tmn24/HAVOC/HVT1.0(DO_NOT_USE)/KICAD8/Stackup.png

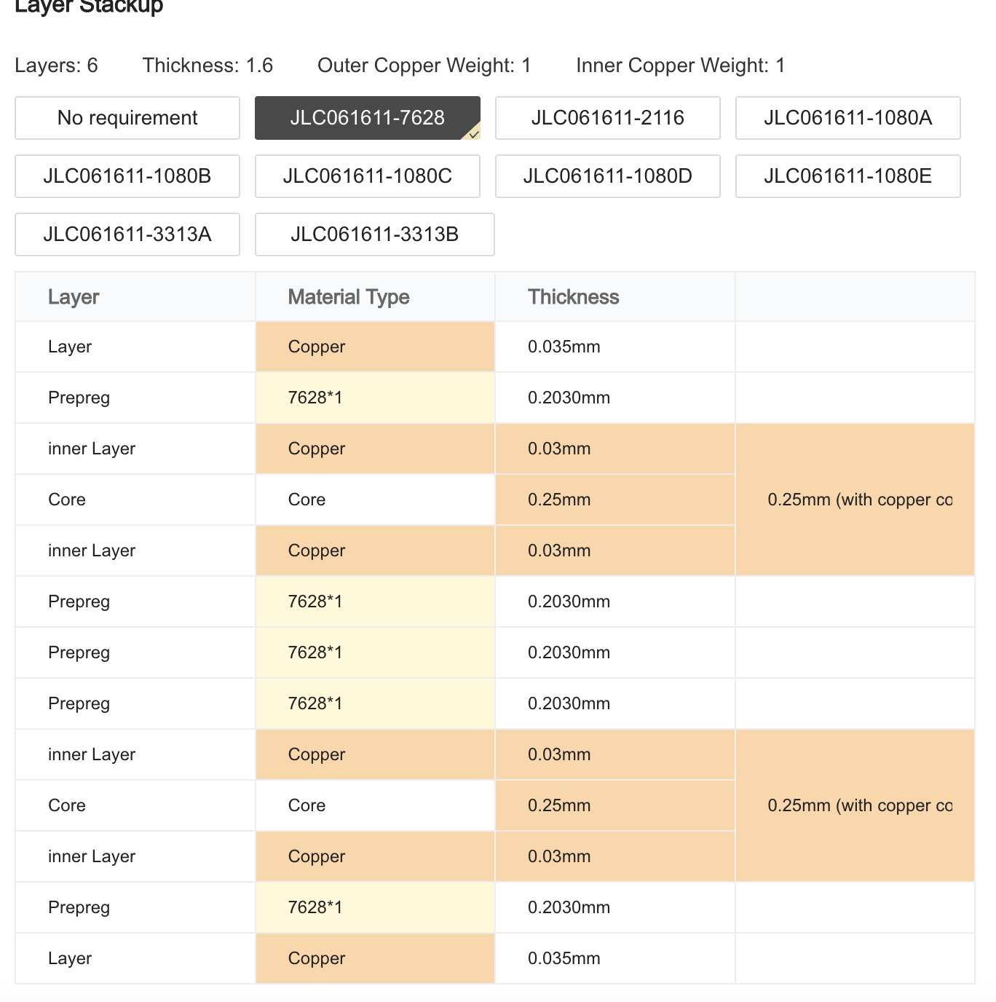
HVT1.0(DO_NOT_USE)/KICAD8/Stackup.png
