tmn24/HAVOC/HVT1.0(DO_NOT_USE)/SYMBOLS&FOOTPRINTS/BMI088/BMI088.step

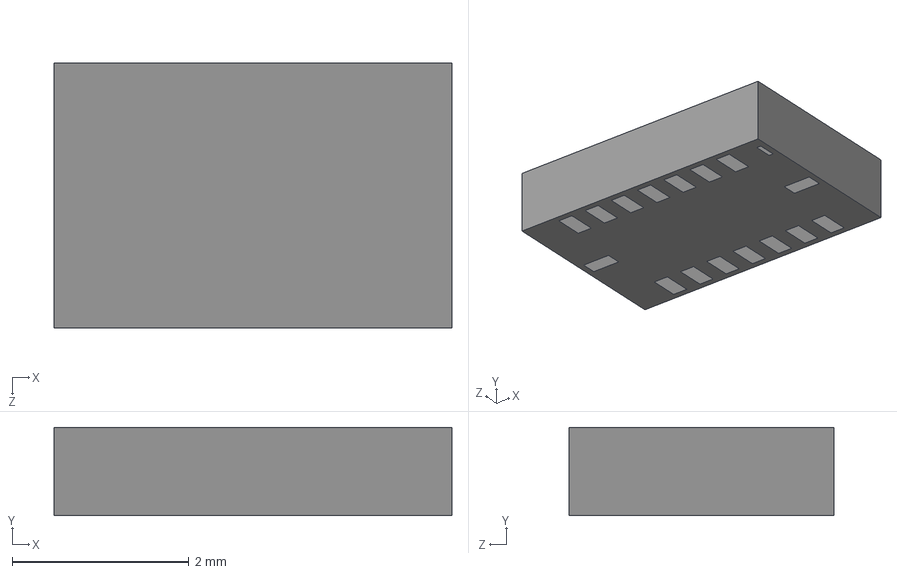
[picture p2: CAD file, 2024-08-04]
HVT1.0(DO_NOT_USE)/SYMBOLS&FOOTPRINTS/BMI088/BMI088.step
4.50 x 1.00 x 3.00 mm
