tmn24/HAVOC/HVT1.0(DO_NOT_USE)/SYMBOLS&FOOTPRINTS/LIB_VOL617A-3X001T/VOL617A-3X001T/KiCad/VOL617A-3X001T.STEP

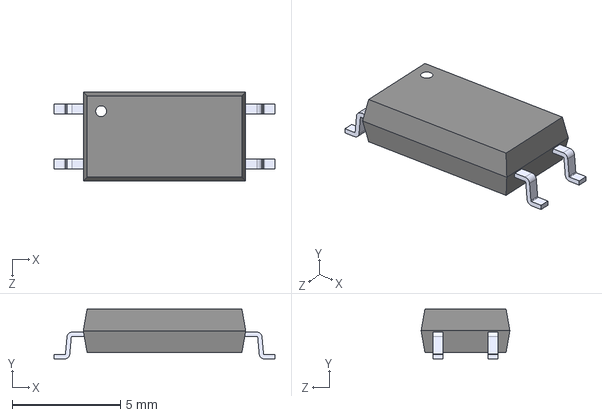
[picture p3: CAD file, 2024-08-04]
HVT1.0(DO_NOT_USE)/SYMBOLS&FOOTPRINTS/LIB_VOL617A-3X001T/VOL617A-3X001T/KiCad/VOL617A-3X001T.STEP
10.2 x 2.30 x 4.10 mm
