tmn24/HAVOC/HVT1.0(DO_NOT_USE)/SYMBOLS&FOOTPRINTS/NR6028T4R7M/NR6028T4R7M.step

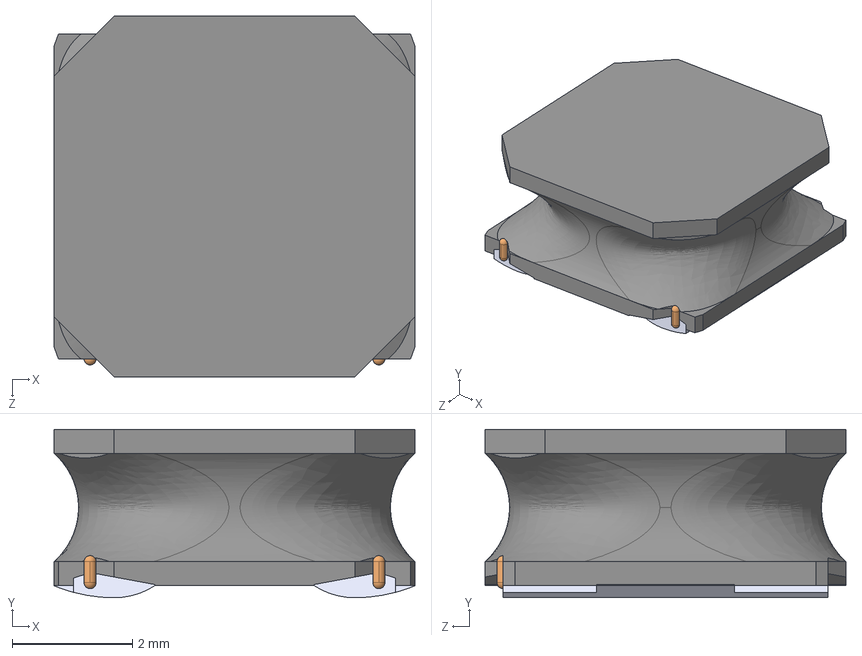
[picture p4: CAD file, 2024-08-04]
HVT1.0(DO_NOT_USE)/SYMBOLS&FOOTPRINTS/NR6028T4R7M/NR6028T4R7M.step
6.00 x 2.80 x 6.00 mm
