tmn24/HAVOC/HVT1.0(DO_NOT_USE)/SYMBOLS&FOOTPRINTS/SSB43L_E3_52T/SSB43L-E3_52T.STEP

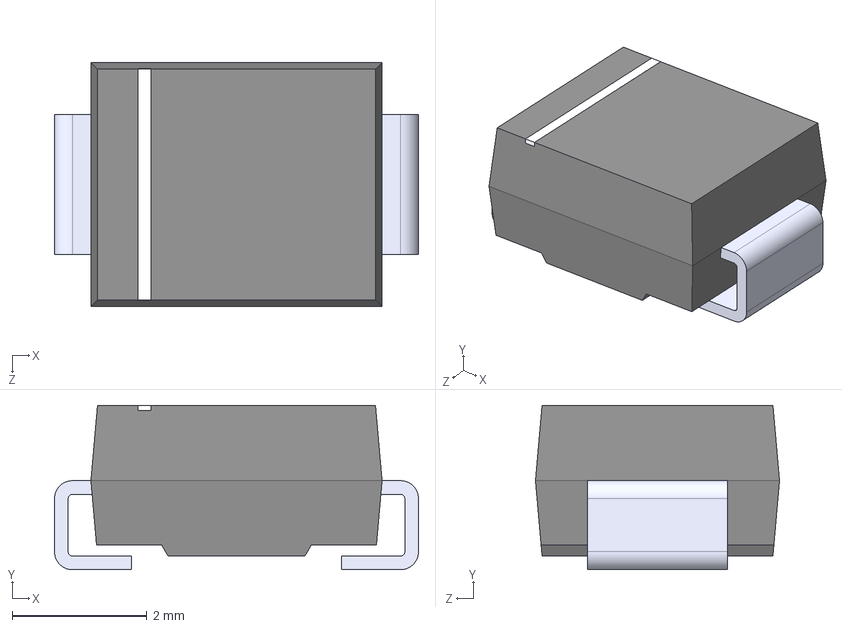
[picture p5: CAD file, 2024-08-04]
HVT1.0(DO_NOT_USE)/SYMBOLS&FOOTPRINTS/SSB43L_E3_52T/SSB43L-E3_52T.STEP
5.40 x 2.44 x 3.62 mm
