tmn24/HAVOC/HVT1.0(DO_NOT_USE)/SYMBOLS&FOOTPRINTS/STM32H755IIT6/LQFP-176.step

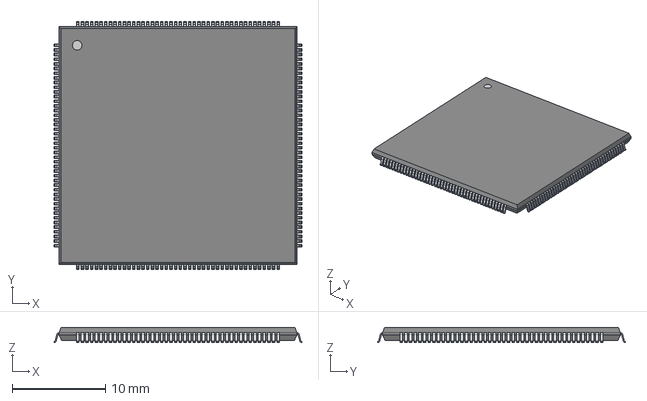
[picture p6: CAD file, 2024-08-04]
HVT1.0(DO_NOT_USE)/SYMBOLS&FOOTPRINTS/STM32H755IIT6/LQFP-176.step
26.6 x 26.6 x 1.65 mm
