tmn24/HAVOC/HVT1.0(DO_NOT_USE)/SYMBOLS&FOOTPRINTS/to-252-n-mosfet/to252-NMOSFET.step

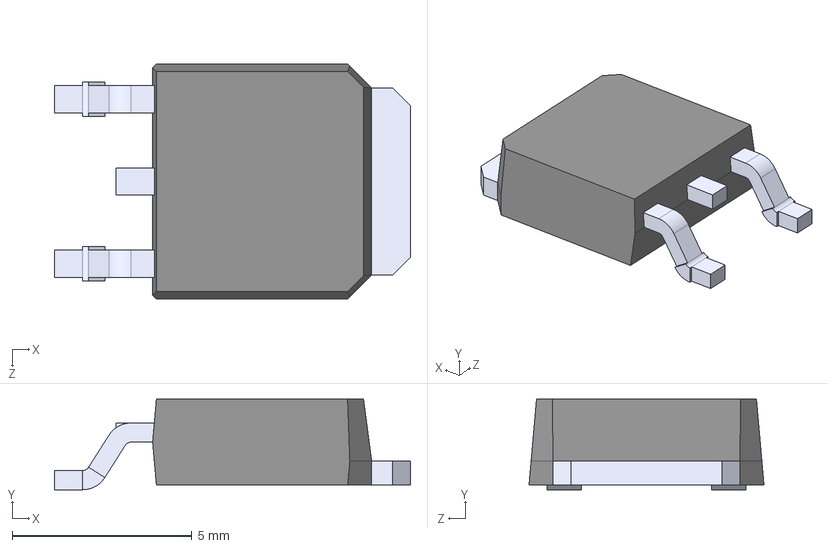
[picture p7: CAD file, 2024-08-04]
HVT1.0(DO_NOT_USE)/SYMBOLS&FOOTPRINTS/to-252-n-mosfet/to252-NMOSFET.step
9.91 x 2.52 x 6.54 mm
