tmn24/HAVOC/HVT1.0(DO_NOT_USE)/SYMBOLS&FOOTPRINTS/W25N01GVZEIG_TR/W25N01GVZEIG_TR.step

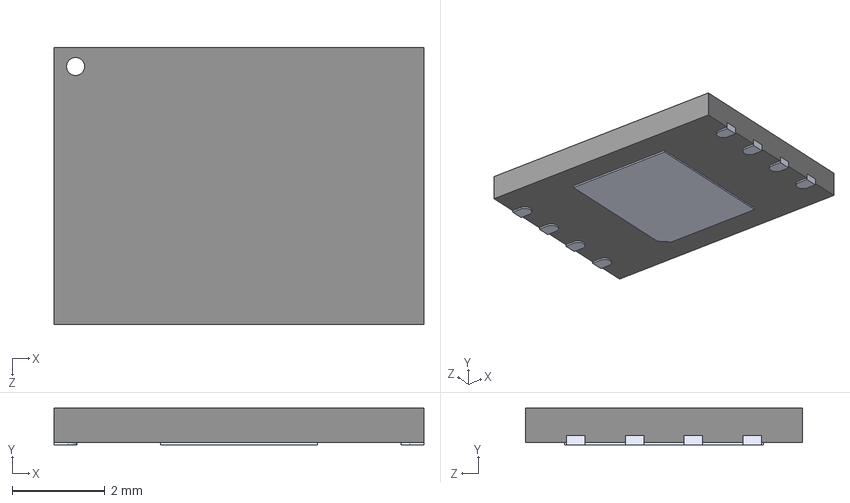
[picture p8: CAD file, 2024-08-04]
HVT1.0(DO_NOT_USE)/SYMBOLS&FOOTPRINTS/W25N01GVZEIG_TR/W25N01GVZEIG_TR.step
8.00 x 0.8 x 6.00 mm
