tmn24/HAVOC/HVT1.0(DO_NOT_USE)/SYMBOLS&FOOTPRINTS/SOIC8.STEP

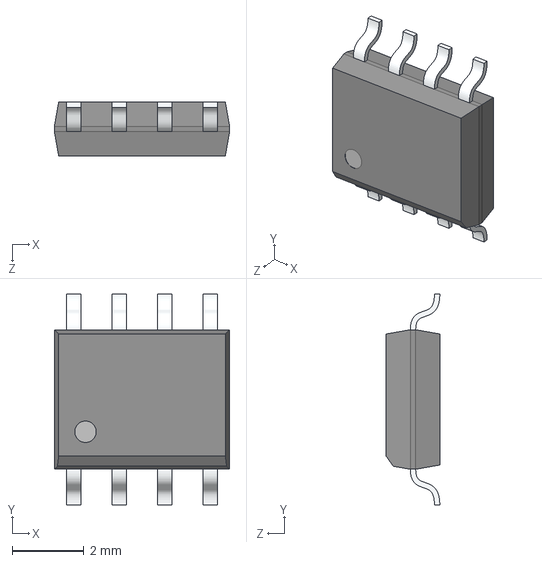
[picture p9: CAD file, 2024-08-04]
HVT1.0(DO_NOT_USE)/SYMBOLS&FOOTPRINTS/SOIC8.STEP
4.90 x 5.90 x 1.50 mm
