tmn24/HAVOC/HVT1.0(DO_NOT_USE)/SYMBOLS&FOOTPRINTS/c-1734035-2-f-3d.stp

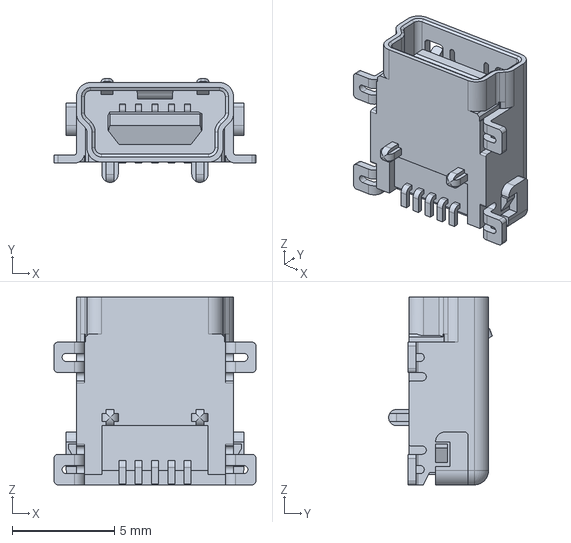
[picture p10: CAD file, 2024-08-04]
HVT1.0(DO_NOT_USE)/SYMBOLS&FOOTPRINTS/c-1734035-2-f-3d.stp
9.90 x 5.09 x 9.20 mm
