tmn24/HAVOC/HVT1.0(DO_NOT_USE)/SYMBOLS&FOOTPRINTS/ASPI4030S3R3M--3DModel-STEP-400430.STEP

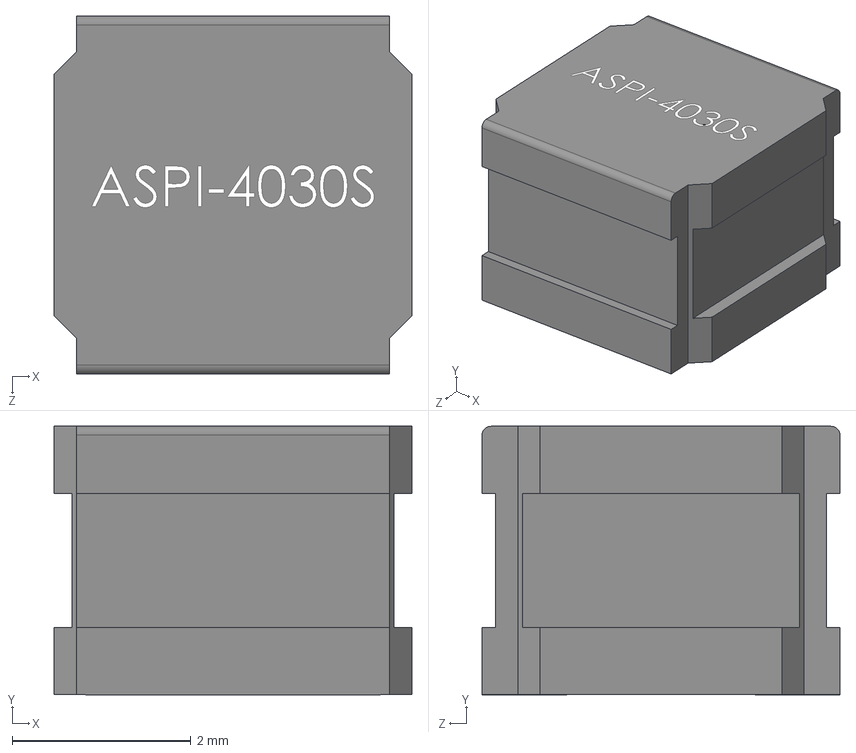
[picture p11: CAD file, 2024-08-04]
HVT1.0(DO_NOT_USE)/SYMBOLS&FOOTPRINTS/ASPI4030S3R3M--3DModel-STEP-400430.STEP
4.00 x 3.00 x 4.00 mm
