tmn24/HAVOC/HVT1.0(DO_NOT_USE)/SYMBOLS&FOOTPRINTS/MAX-M10S-00B--3DModel-STEP-269445.STEP

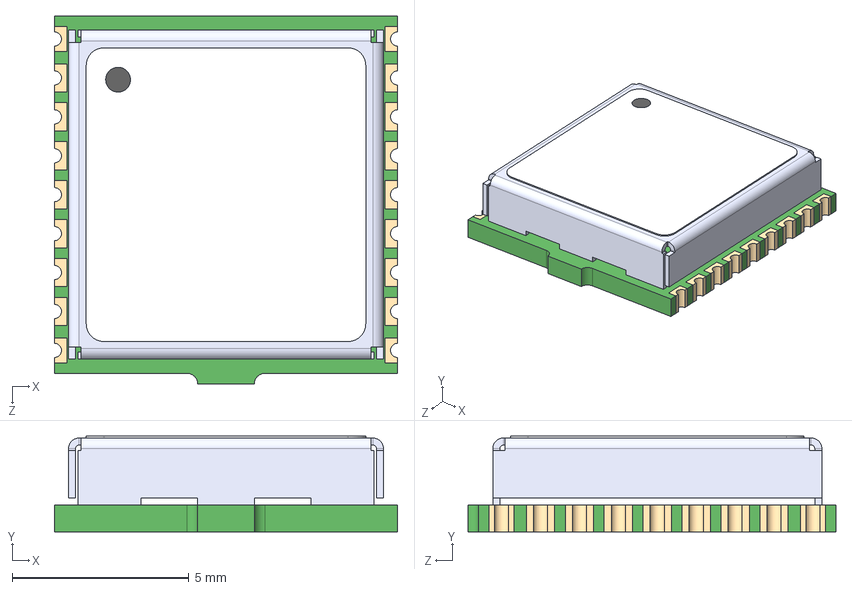
[picture p12: CAD file, 2024-08-04]
HVT1.0(DO_NOT_USE)/SYMBOLS&FOOTPRINTS/MAX-M10S-00B--3DModel-STEP-269445.STEP
9.70 x 2.70 x 10.4 mm
