tmn24/HAVOC/HVT1.0(DO_NOT_USE)/SYMBOLS&FOOTPRINTS/RFM95W-915S2--3DModel-STEP-56544.STEP

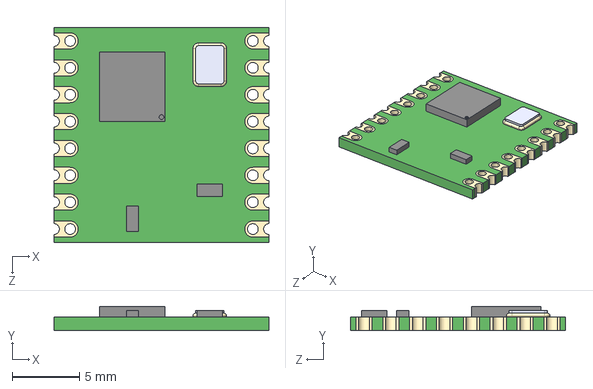
[picture p13: CAD file, 2024-08-04]
HVT1.0(DO_NOT_USE)/SYMBOLS&FOOTPRINTS/RFM95W-915S2--3DModel-STEP-56544.STEP
16.0 x 1.80 x 16.0 mm
