tmn24/HAVOC/HVT1.0(DO_NOT_USE)/SYMBOLS&FOOTPRINTS/9011436RFX--3DModel-STEP-269445.STEP

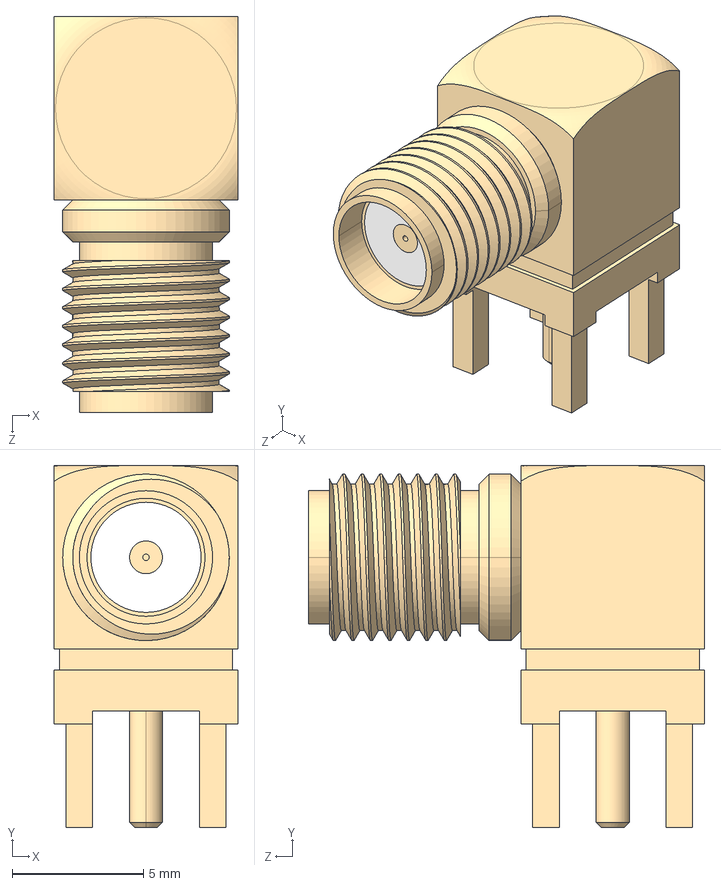
[picture p14: CAD file, 2024-08-04]
HVT1.0(DO_NOT_USE)/SYMBOLS&FOOTPRINTS/9011436RFX--3DModel-STEP-269445.STEP
7.00 x 13.8 x 15.1 mm
