tmn24/HAVOC/HVT1.0(DO_NOT_USE)/SYMBOLS&FOOTPRINTS/OS102011MS2QN1/OS102011MS2QN1.step

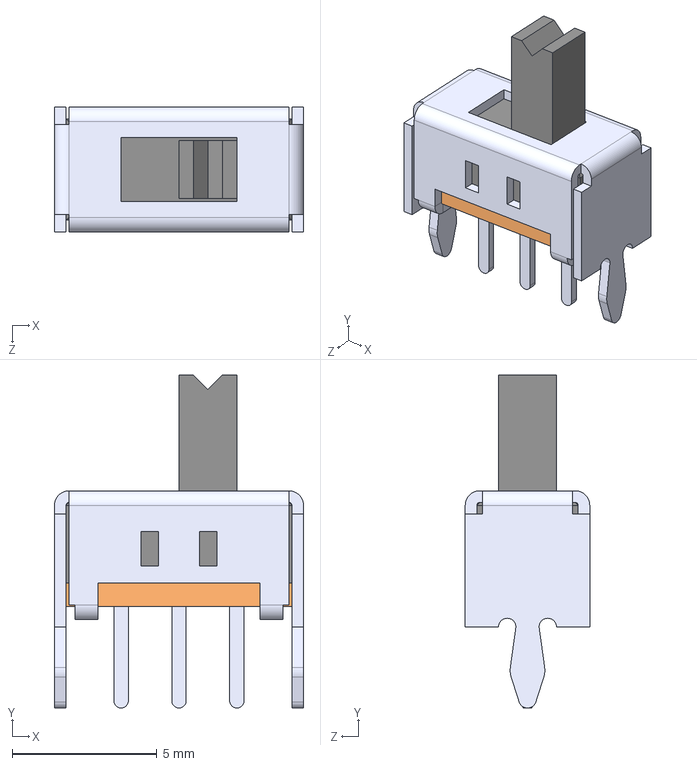
[picture p15: CAD file, 2024-08-04]
HVT1.0(DO_NOT_USE)/SYMBOLS&FOOTPRINTS/OS102011MS2QN1/OS102011MS2QN1.step
8.60 x 11.5 x 4.30 mm
