tmn24/HAVOC/HVT1.0(DO_NOT_USE)/SYMBOLS&FOOTPRINTS/Wuerth_691214110002_Screw_Term/691214110002.step

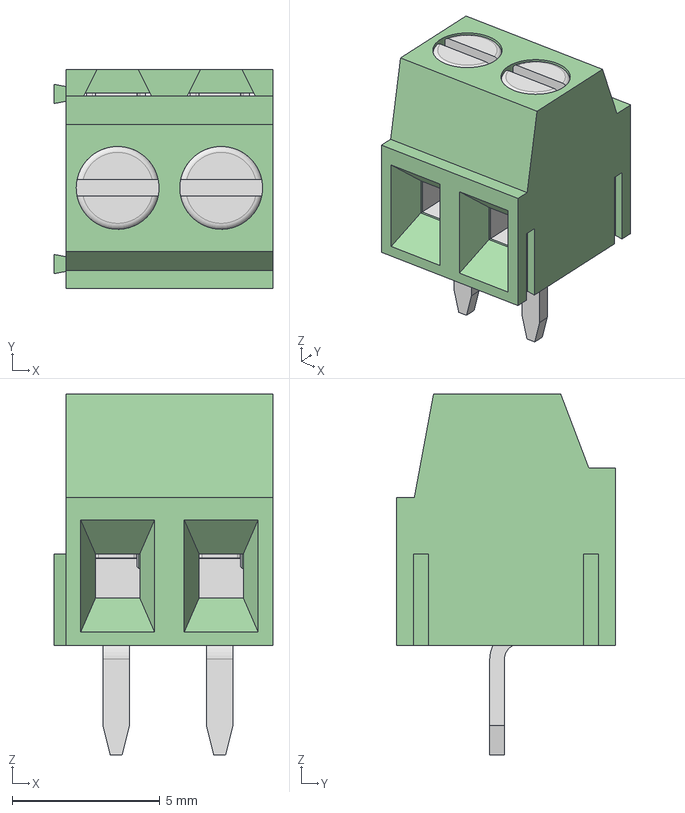
[picture p16: CAD file, 2024-08-04]
HVT1.0(DO_NOT_USE)/SYMBOLS&FOOTPRINTS/Wuerth_691214110002_Screw_Term/691214110002.step
7.40 x 7.40 x 12.2 mm
6912141100xx_CAGE x 2
6912141100xx_PIN x 2
6912141100xx_VIS x 2
