tmn24/HAVOC/HVT1.0(DO_NOT_USE)/SYMBOLS&FOOTPRINTS/Wuerth_691214110002_Screw_Term/691214110002/691214110002.obj

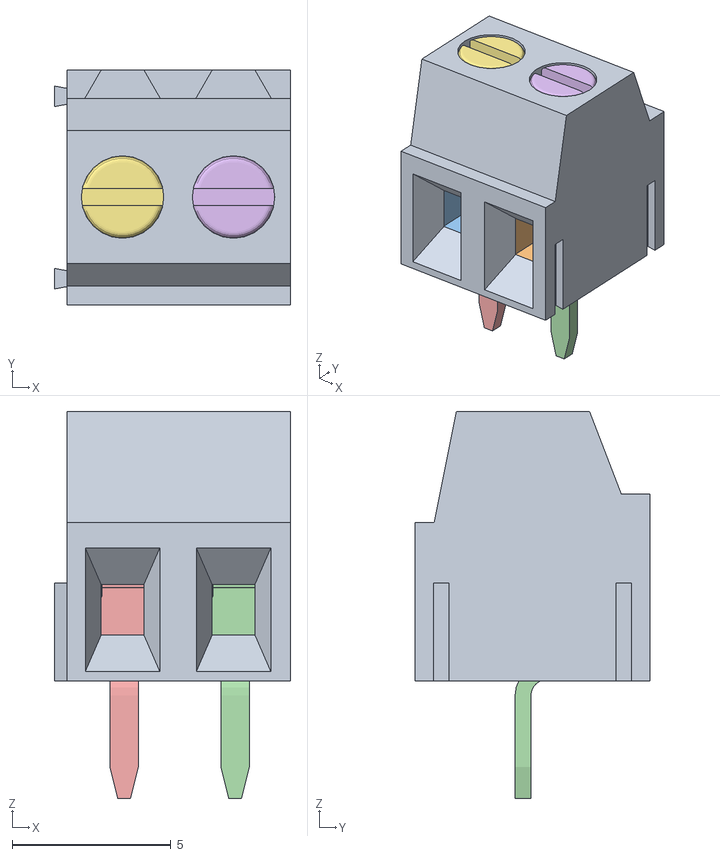
[picture p17: CAD file, 2024-08-04]
HVT1.0(DO_NOT_USE)/SYMBOLS&FOOTPRINTS/Wuerth_691214110002_Screw_Term/691214110002/691214110002.obj
7.45 x 7.40 x 12.2
