tmn24/HAVOC/(list of files, cad)

Other CAD files:
HVT1.0(DO_NOT_USE)/SYMBOLS&FOOTPRINTS/LIB_STM32H755IIT6/STM32H755IIT6/Allegro/qfp50p2600x2600x160-176n.psm
HVT1.0(DO_NOT_USE)/SYMBOLS&FOOTPRINTS/LIB_STM32H755IIT6/STM32H755IIT6/DEHDL/stm32h755iit6/chips/chips.prt
HVT1.0(DO_NOT_USE)/SYMBOLS&FOOTPRINTS/LIB_VOL617A-3X001T/VOL617A-3X001T/Allegro/sop254p1015x230-4n.psm
HVT1.0(DO_NOT_USE)/SYMBOLS&FOOTPRINTS/LIB_VOL617A-3X001T/VOL617A-3X001T/DEHDL/vol617a_3x001t/chips/chips.prt
