tmn24/HAVOC/SCHEMATIC/COMMIT_2/havoc-schematic-REV2.pdf

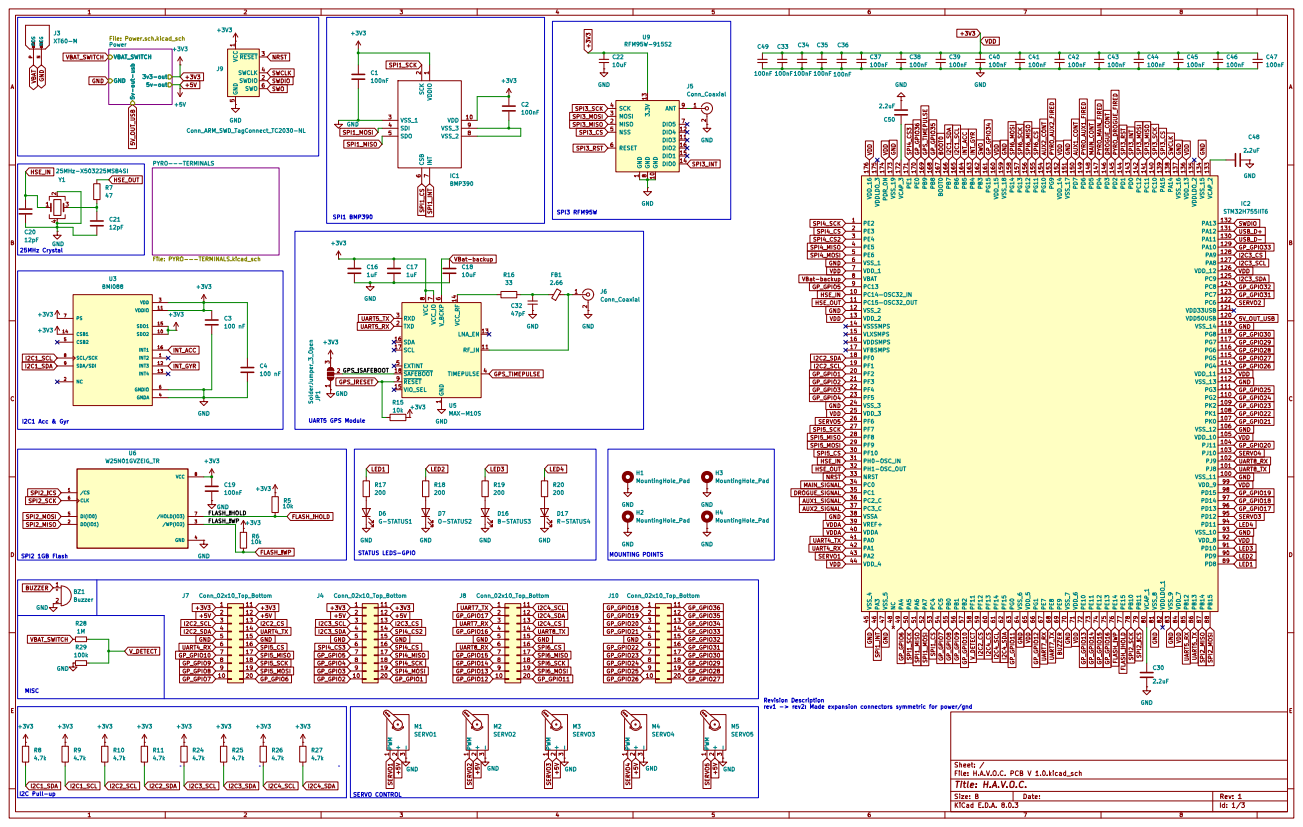
[picture p18: page 1]

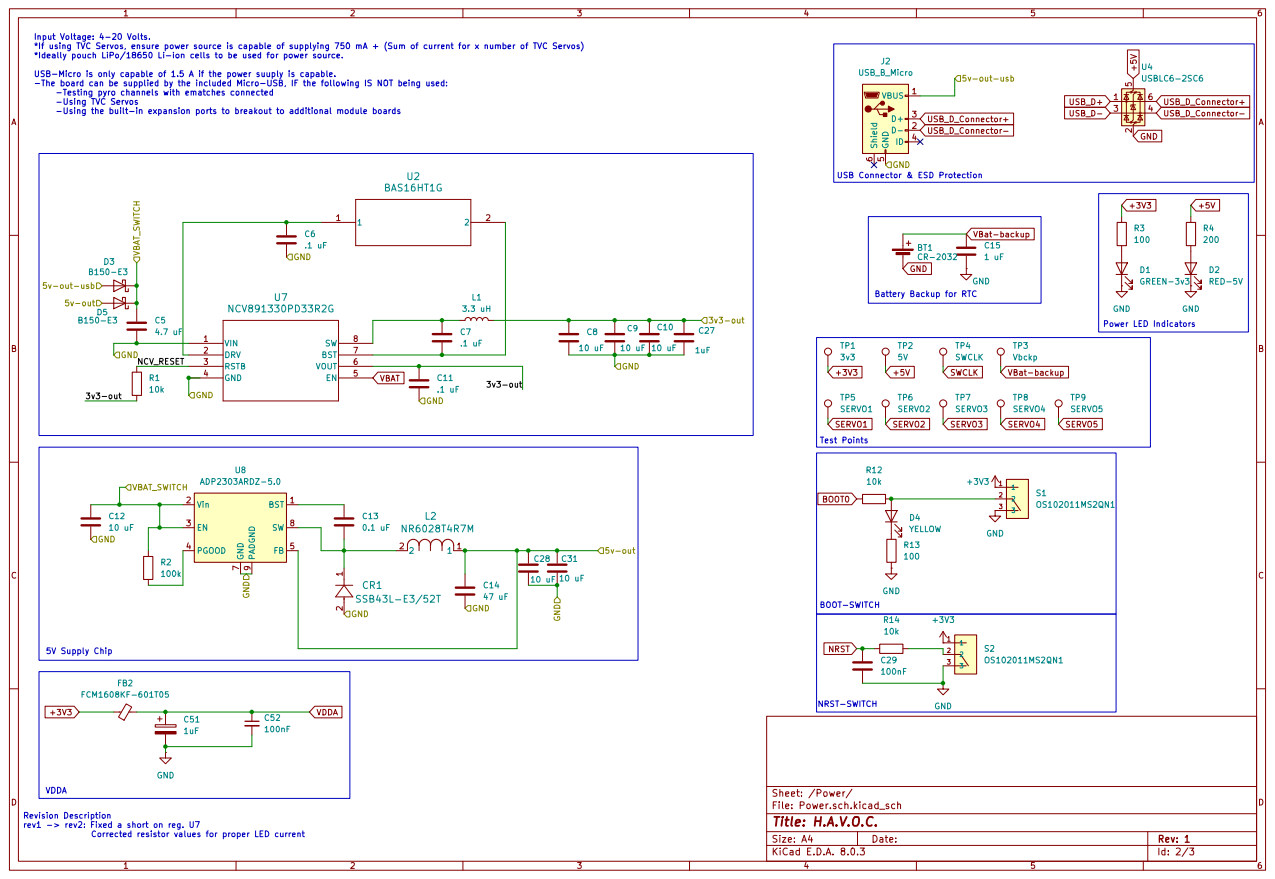
[picture p19: page 2]

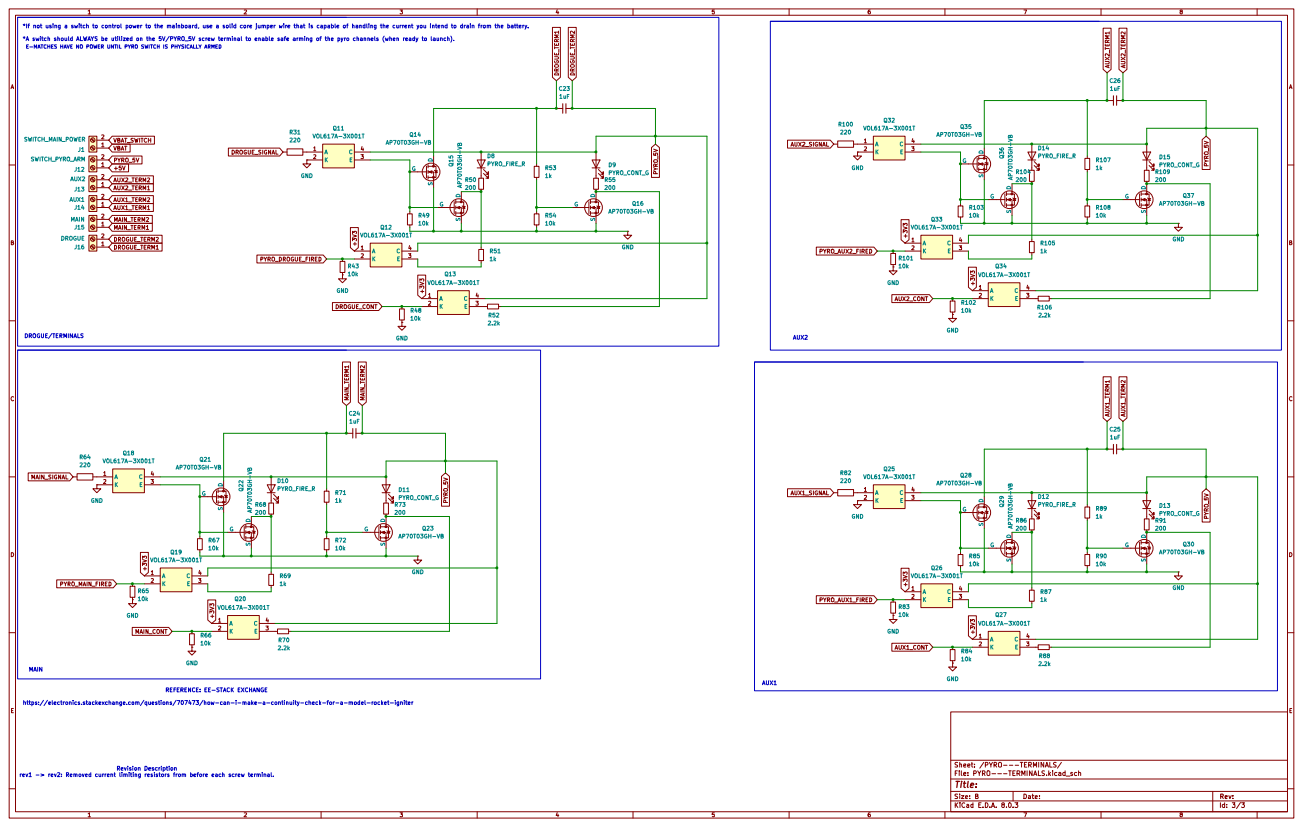
[picture p20: page 3]
