tmn24/HAVOC/HVT1.0(DO_NOT_USE)/SCHEMATIC&PCB/COMMIT_4/Layer_Images.pdf

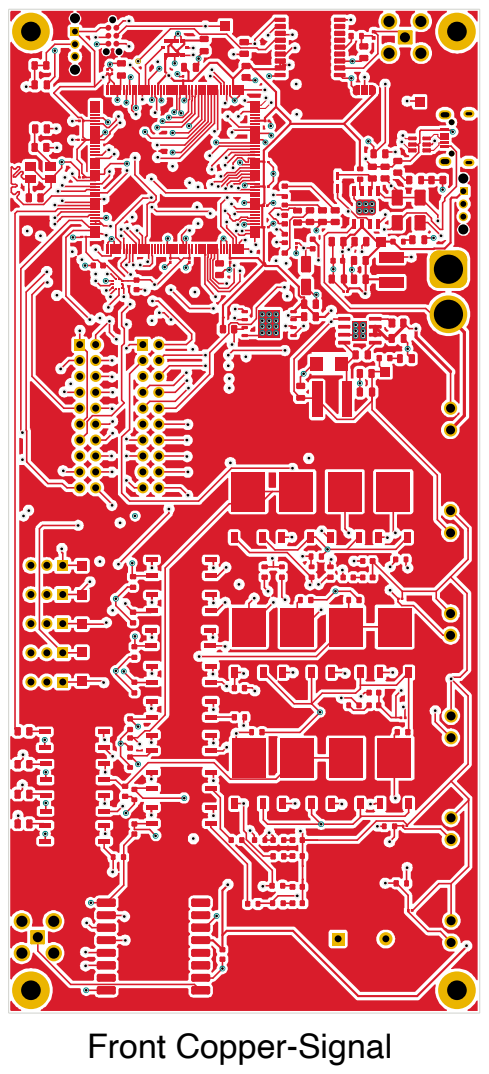
[picture p21: page 1]

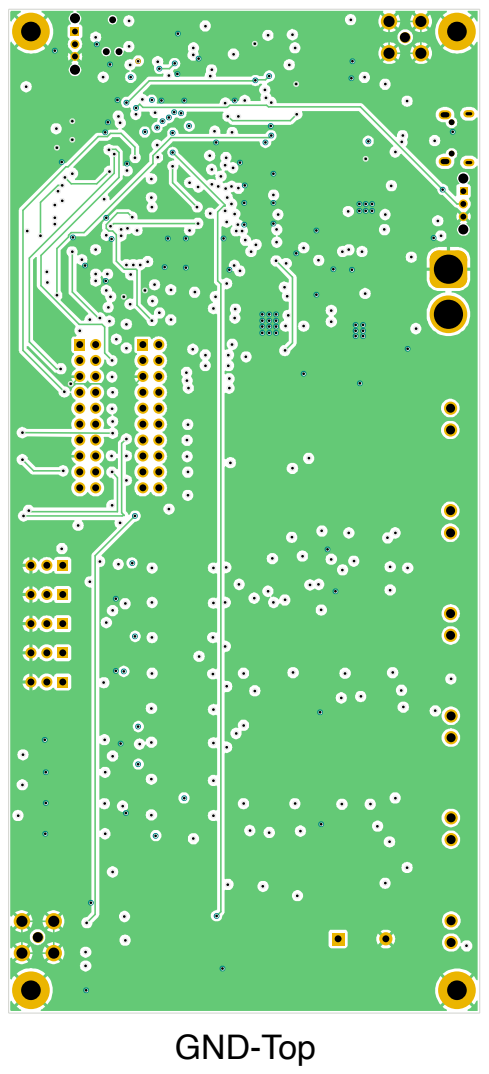
[picture p22: page 2]

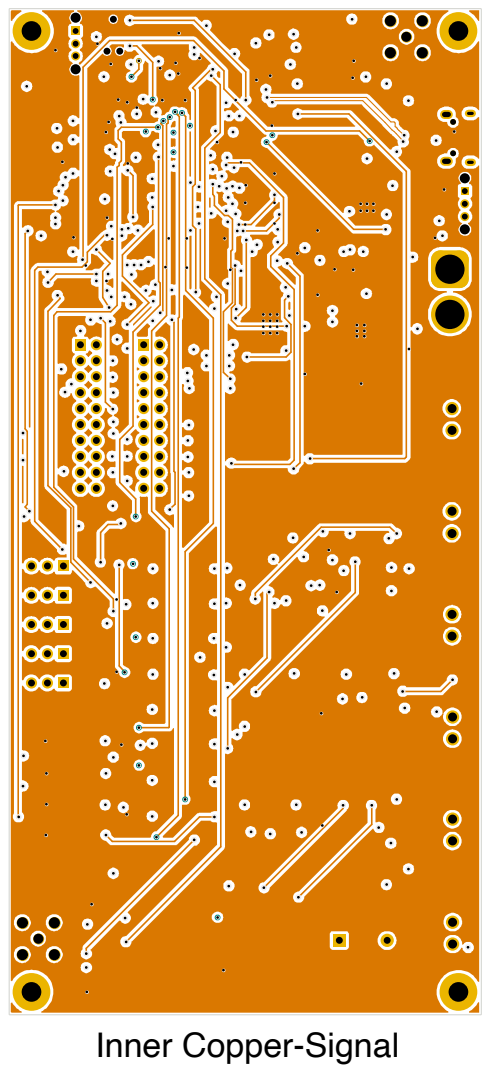
[picture p23: page 3]

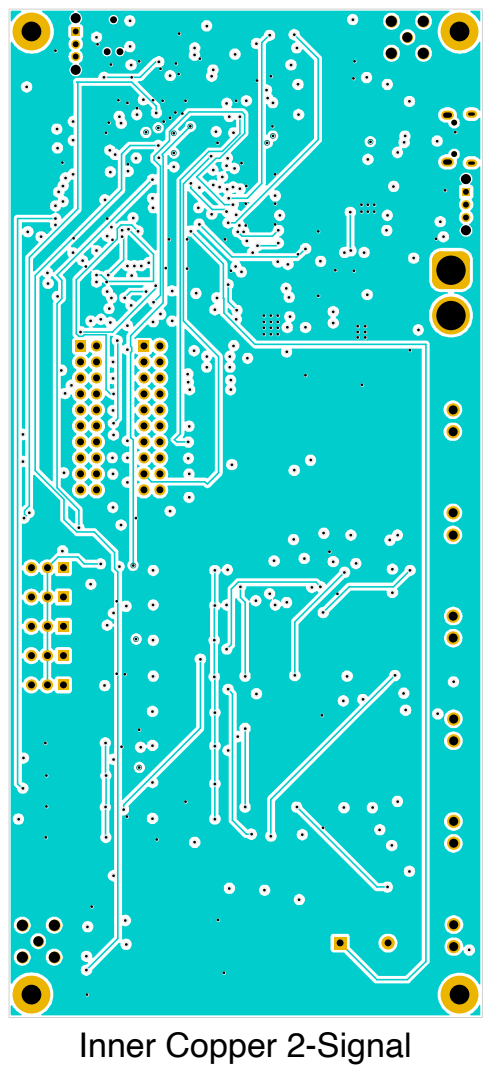
[picture p24: page 4]

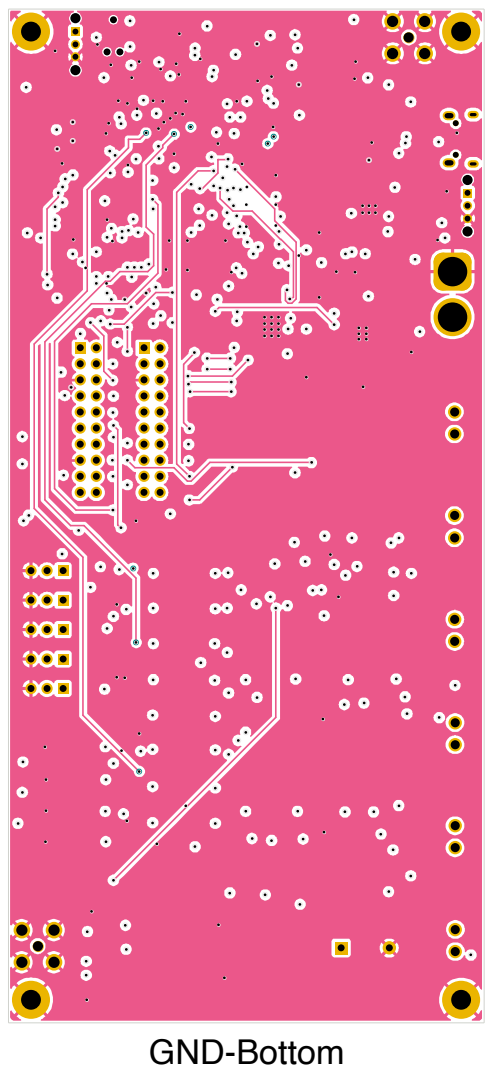
[picture p25: page 5]

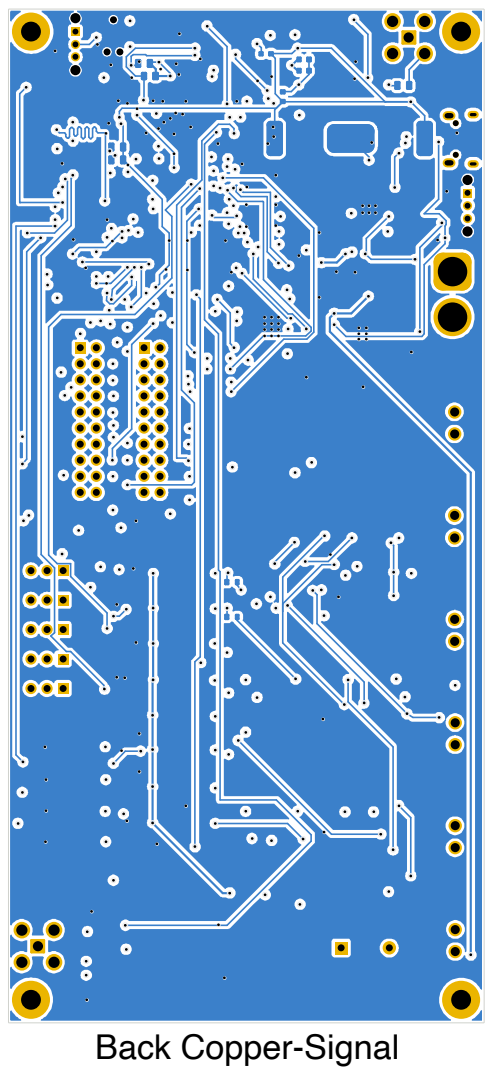
[picture p26: page 6]
