tmn24/HAVOC/HVT1.0(DO_NOT_USE)/SCHEMATIC&PCB/COMMIT_4/havoc-schematic-REV3.pdf

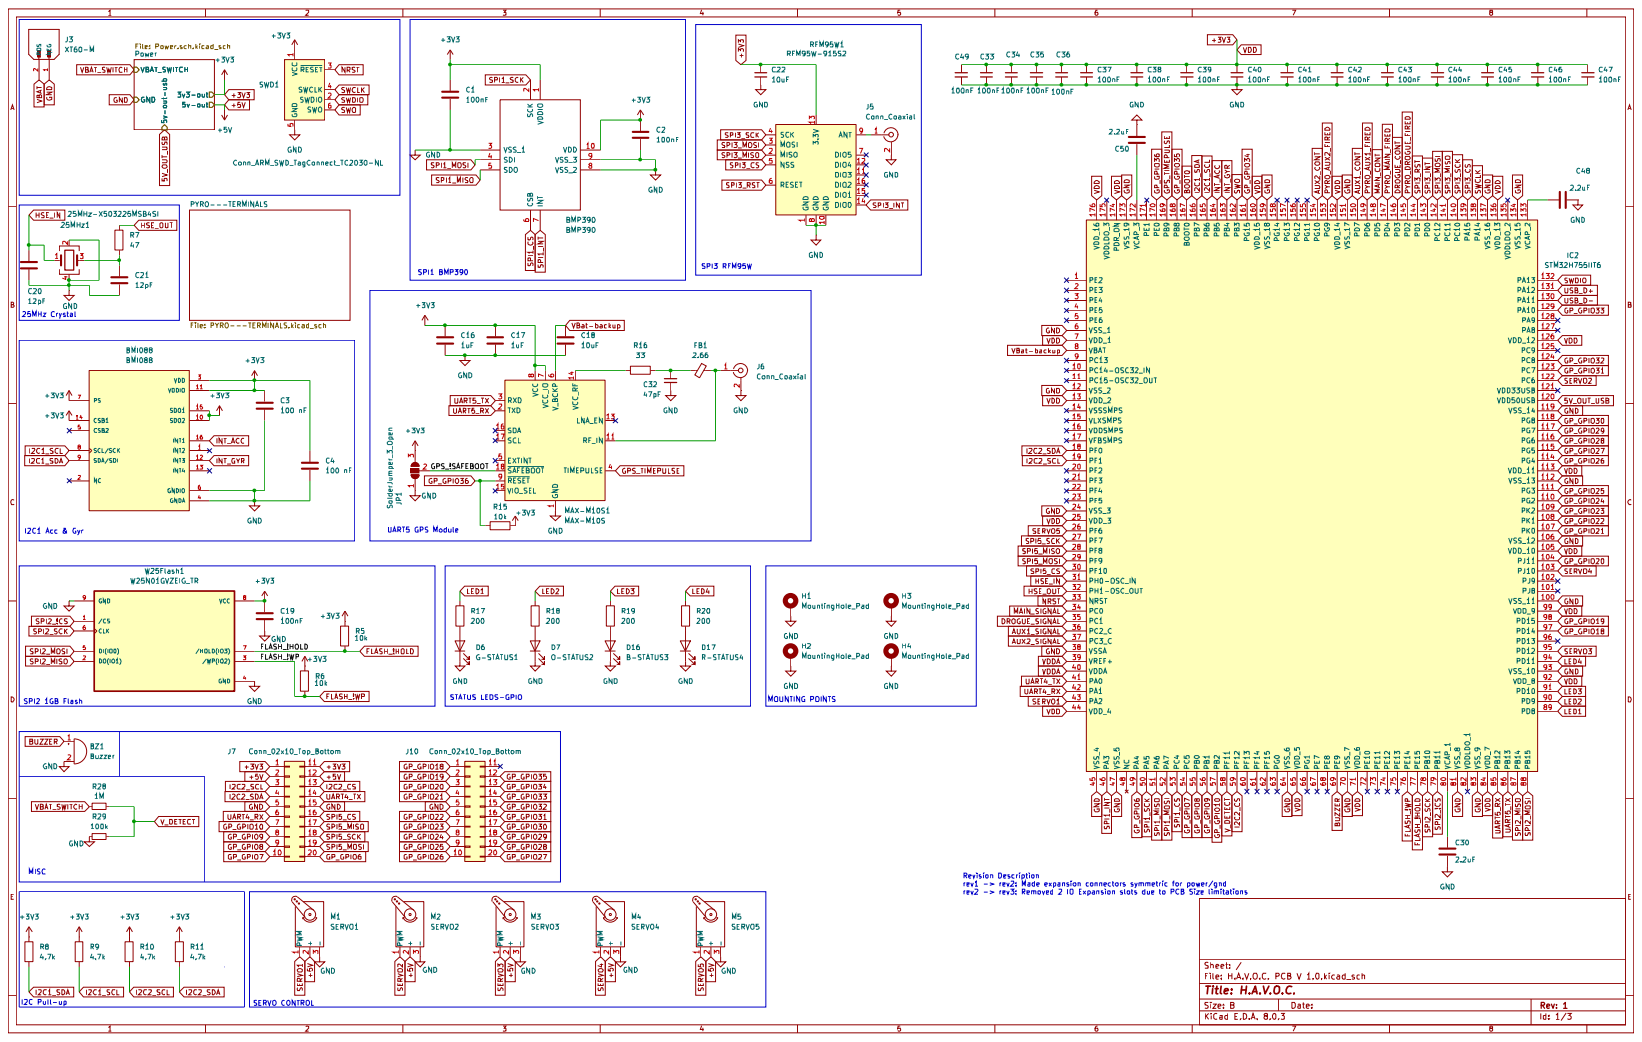
[picture p27: page 1]

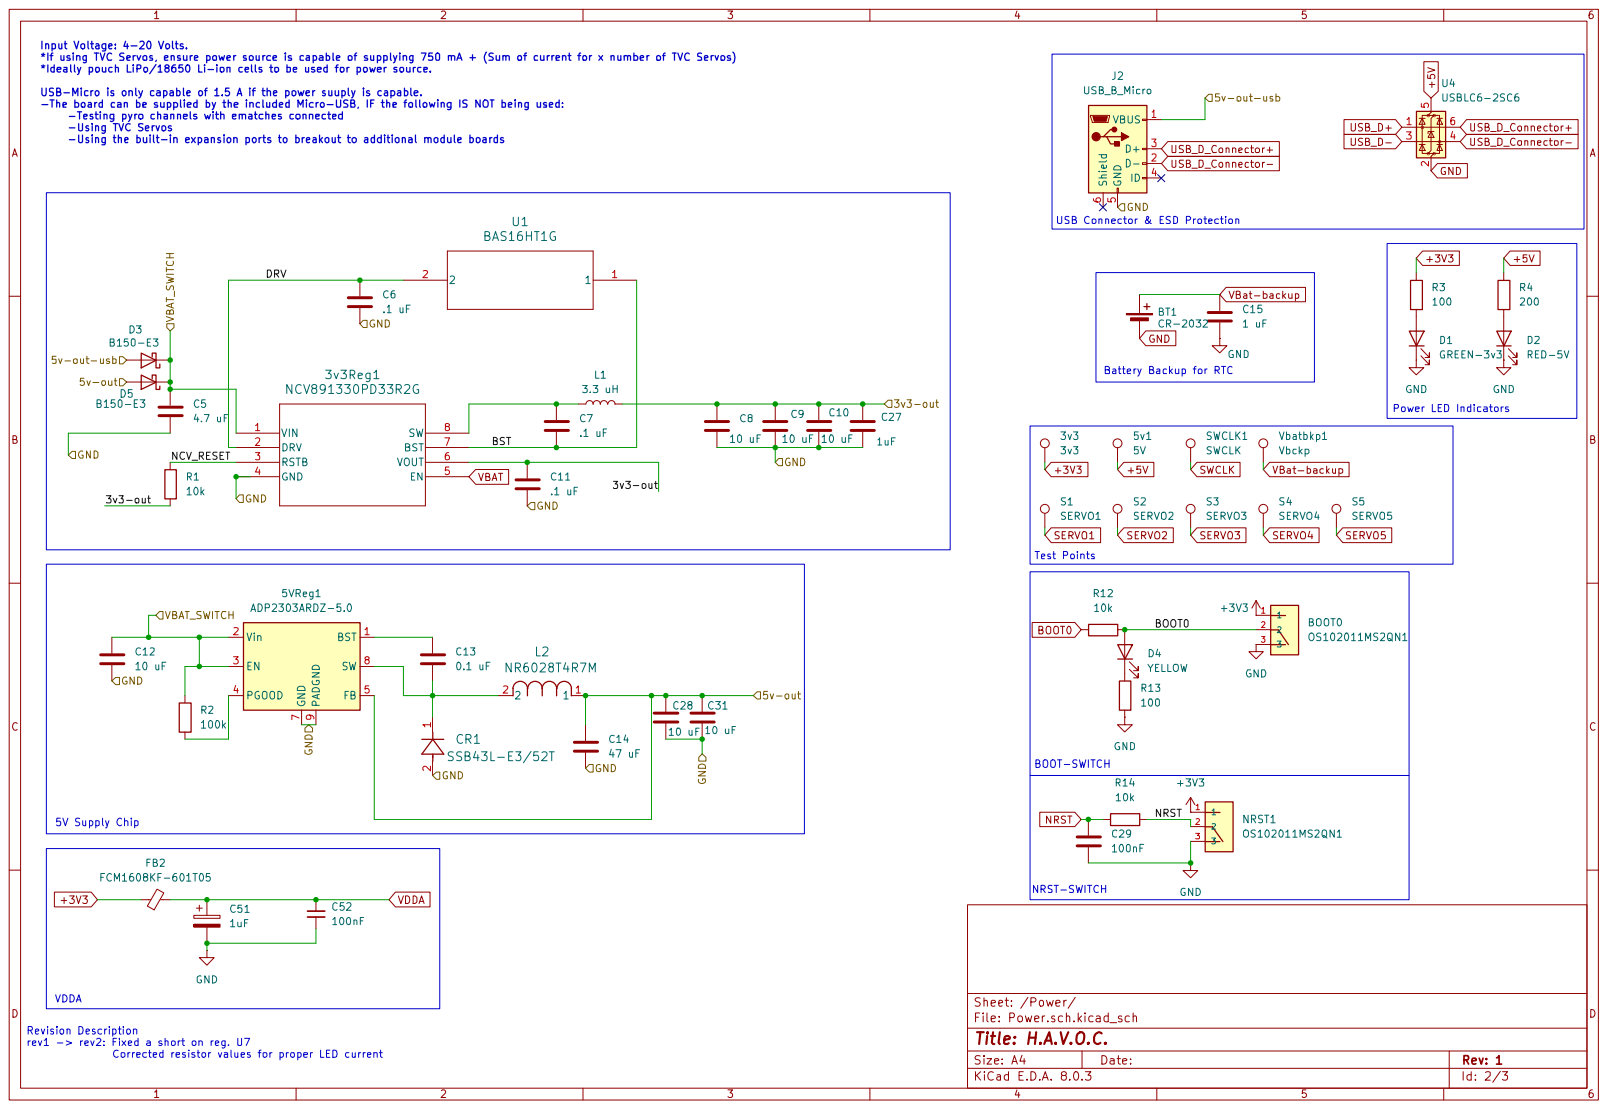
[picture p28: page 2]

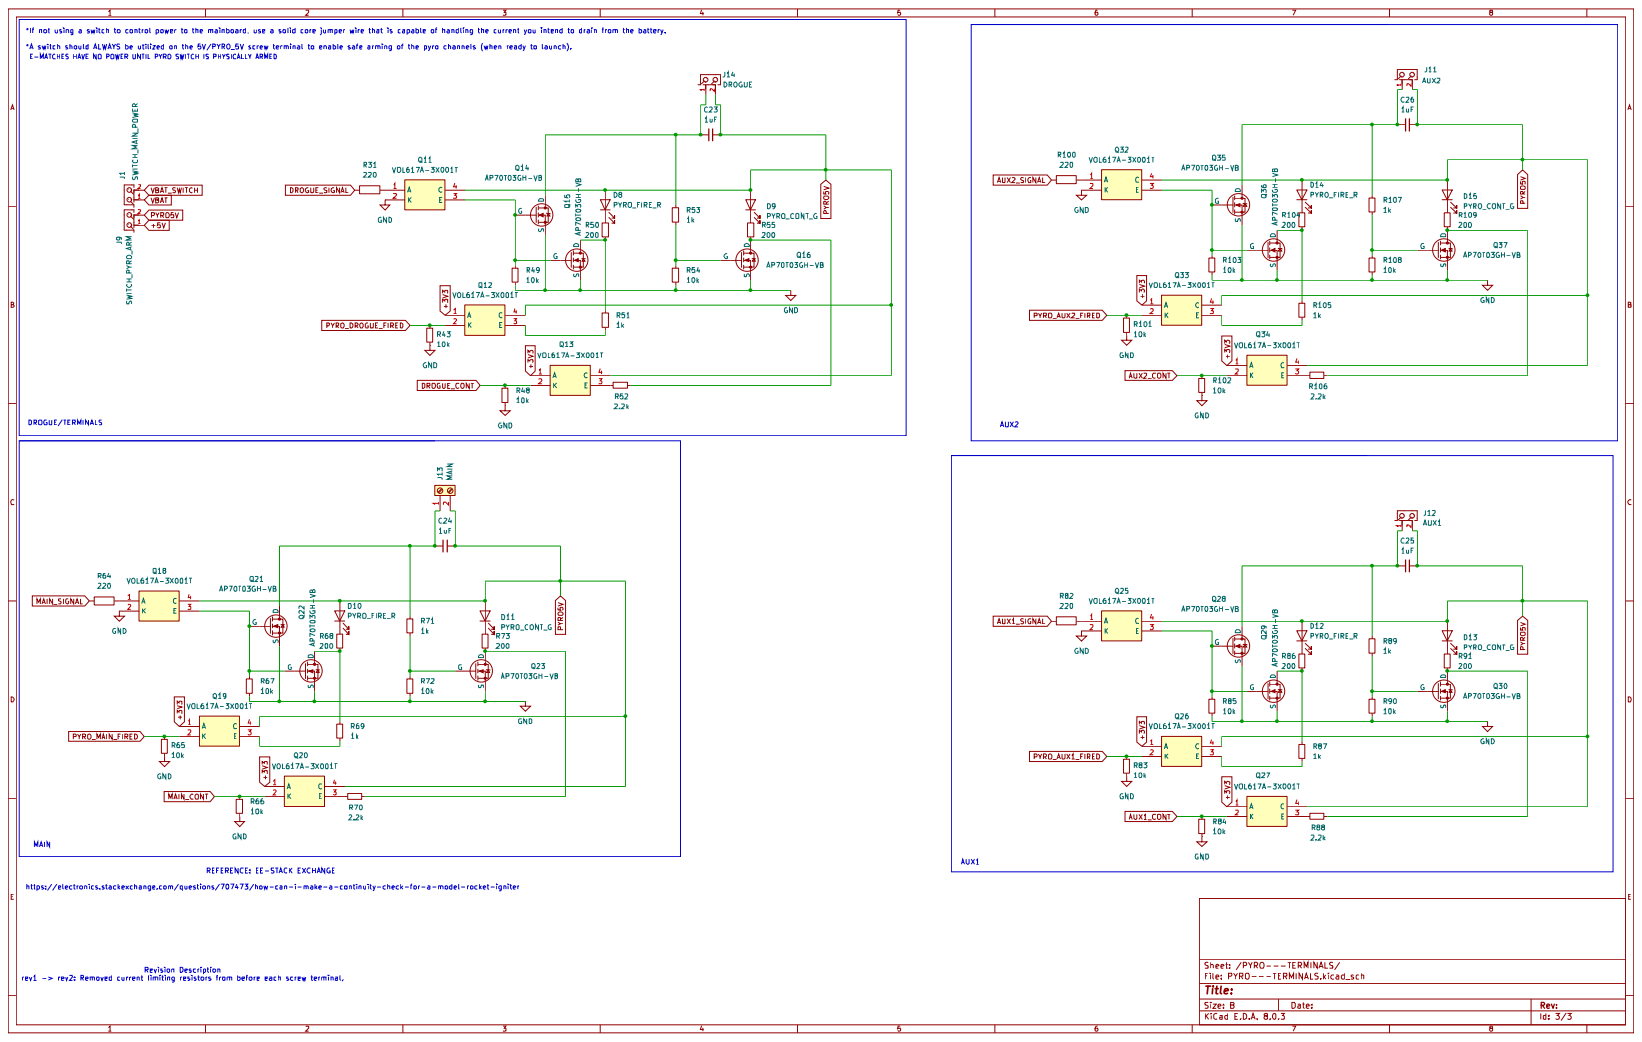
[picture p29: page 3]
