tmn24/HAVOC/HVT1.0(DO_NOT_USE)/ARCHIVED/SCHEMATIC/COMMIT_3/Layer_Images.pdf

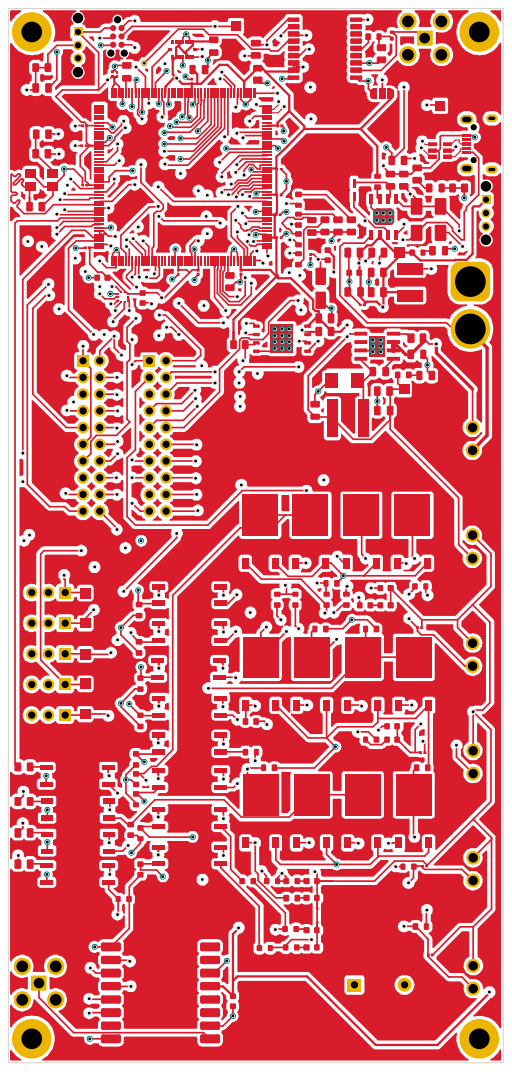
[picture p30: page 1]

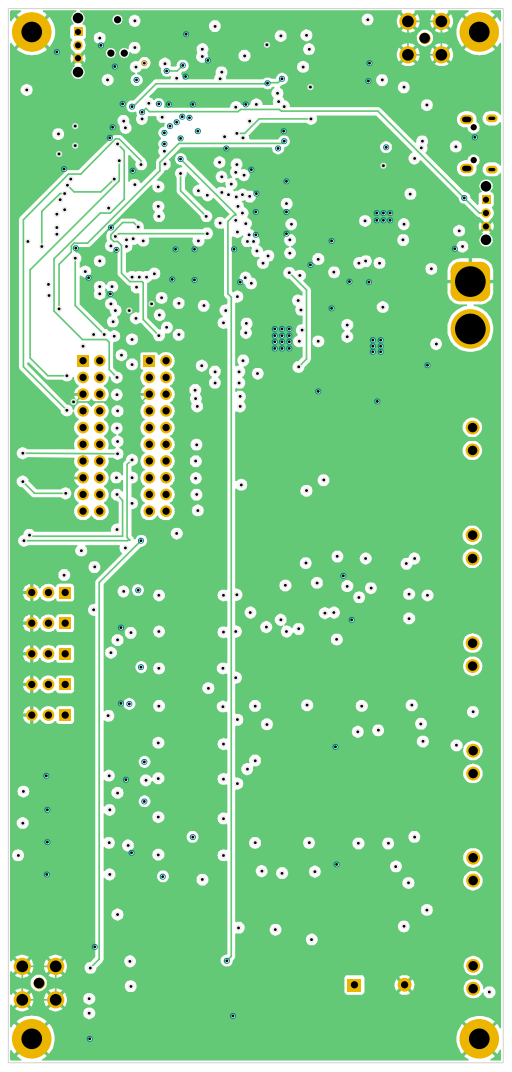
[picture p31: page 2]

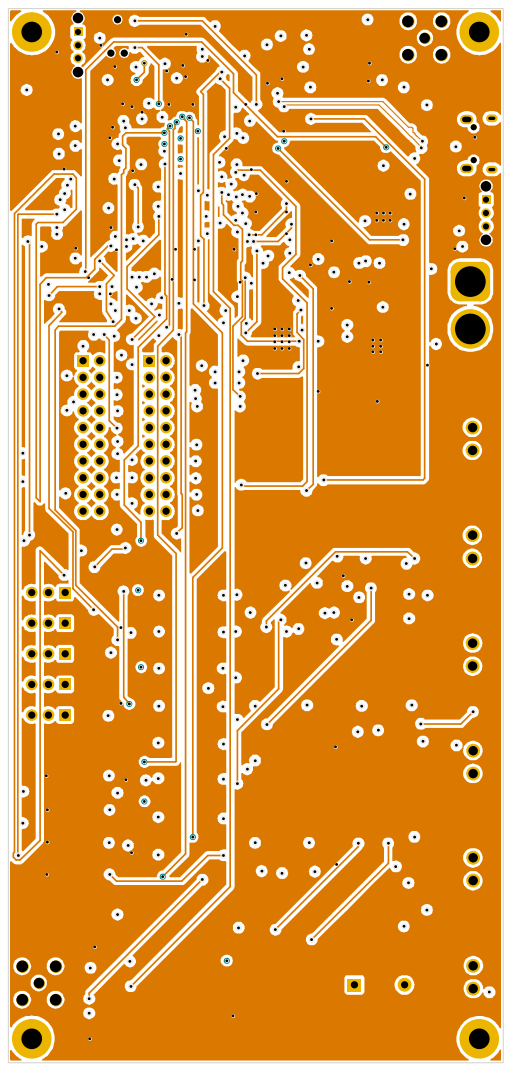
[picture p32: page 3]

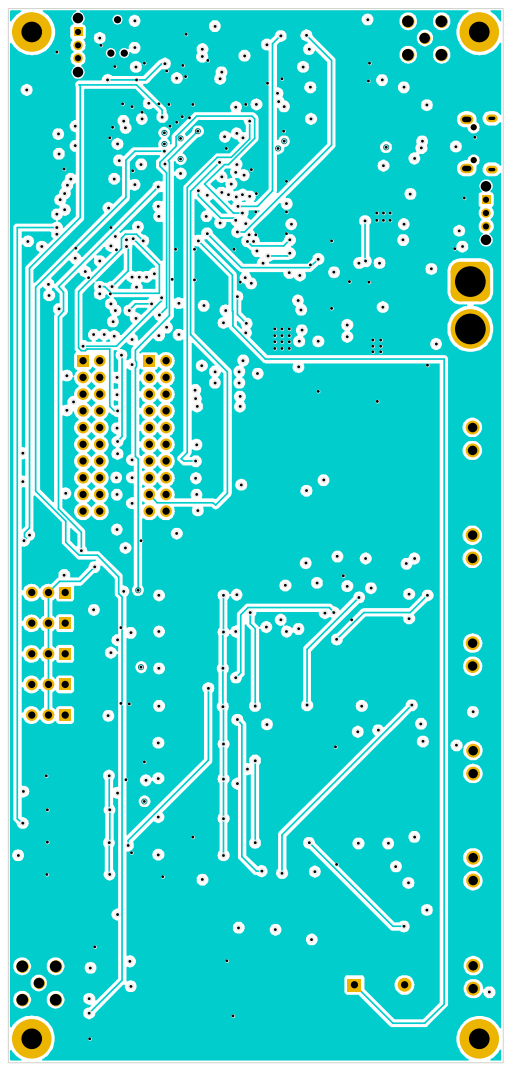
[picture p33: page 4]

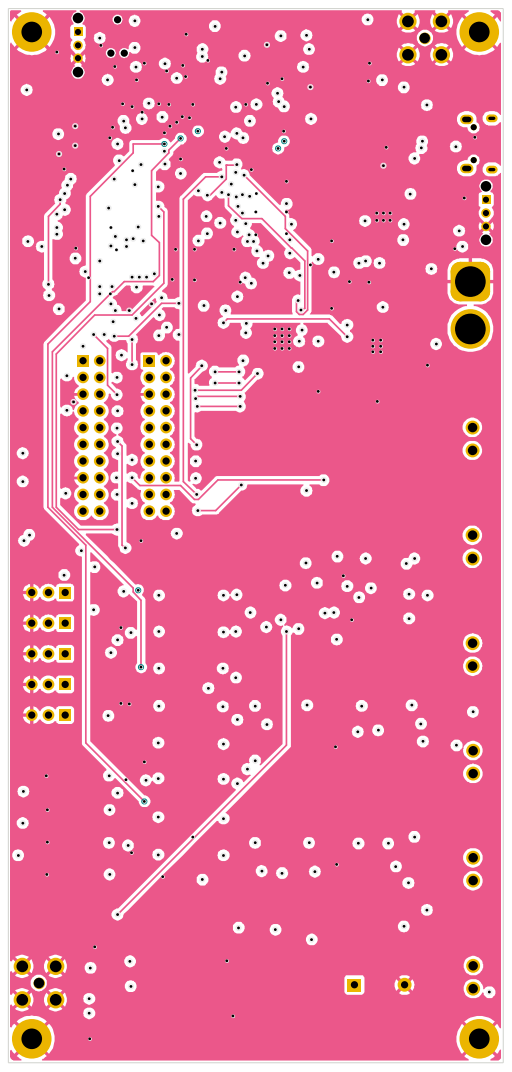
[picture p34: page 5]

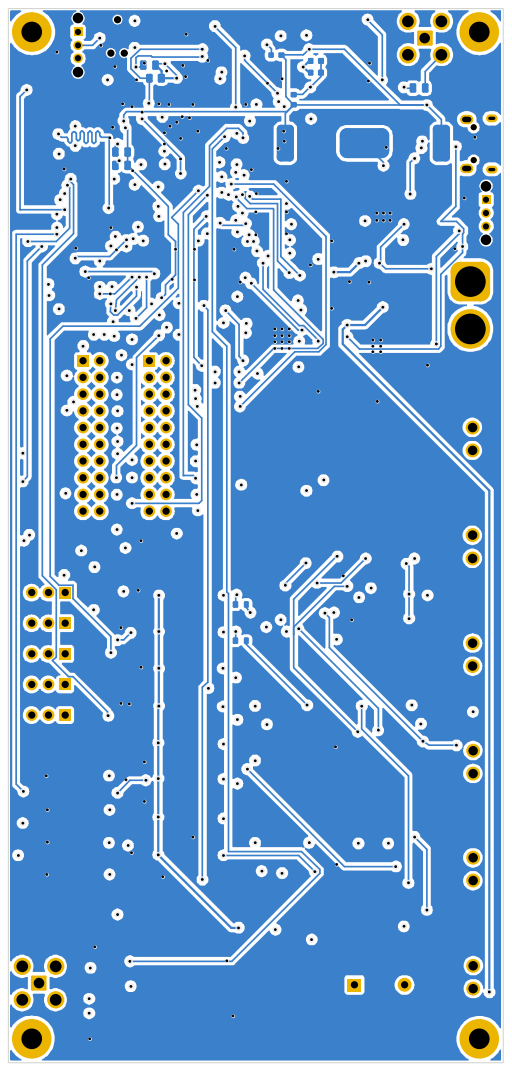
[picture p35: page 6]
