tmn24/HAVOC/HVT1.0(DO_NOT_USE)/ARCHIVED/SCHEMATIC/COMMIT_1/havoc-schematic.pdf

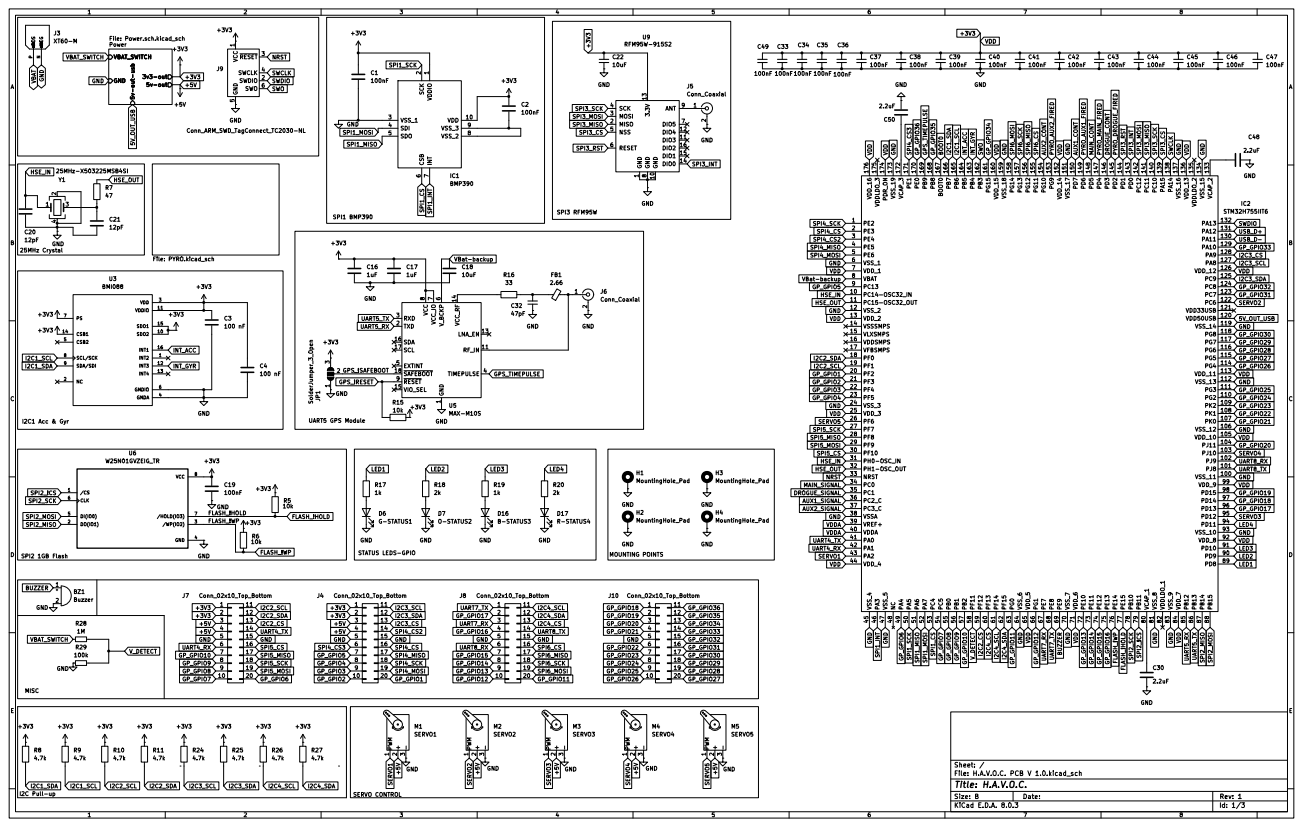
[picture p36: page 1]

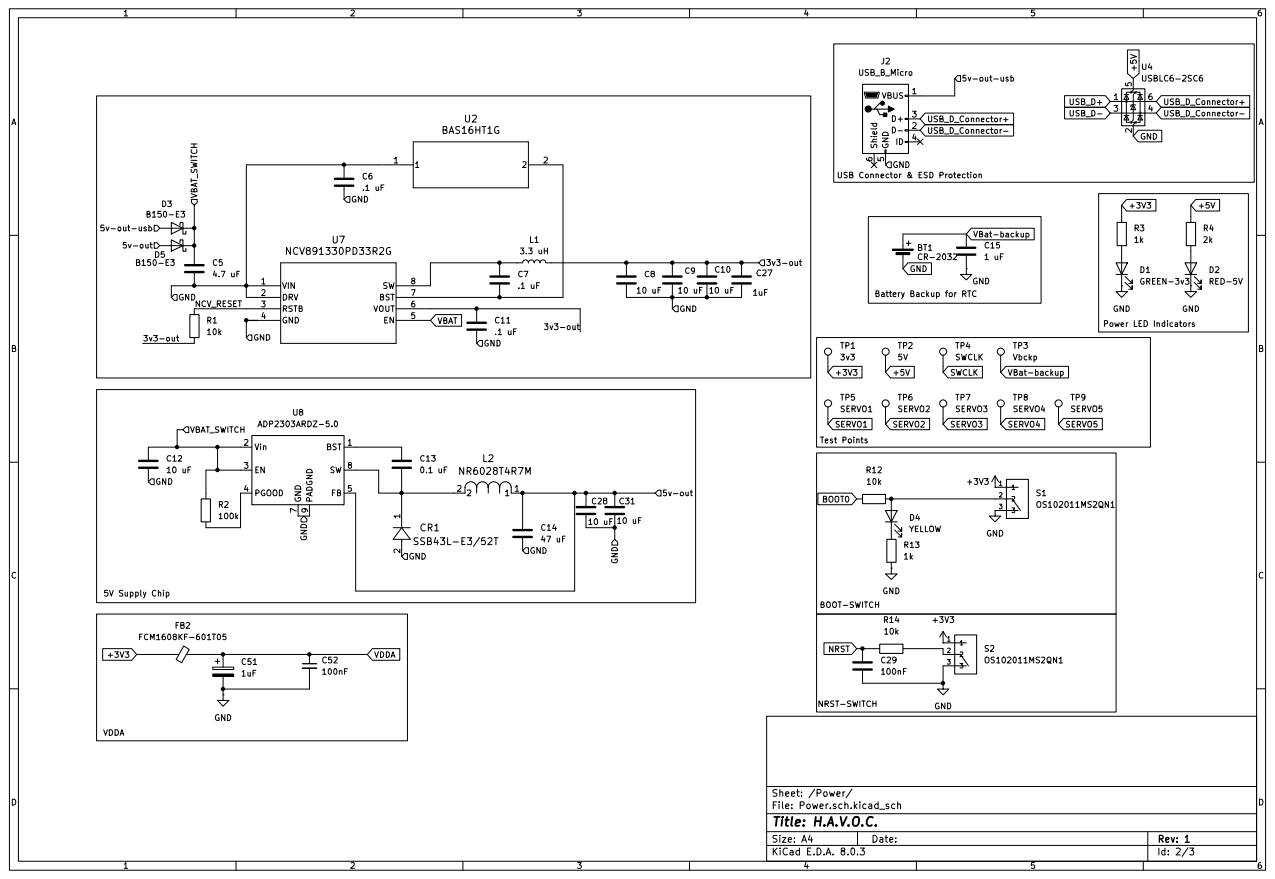
[picture p37: page 2]

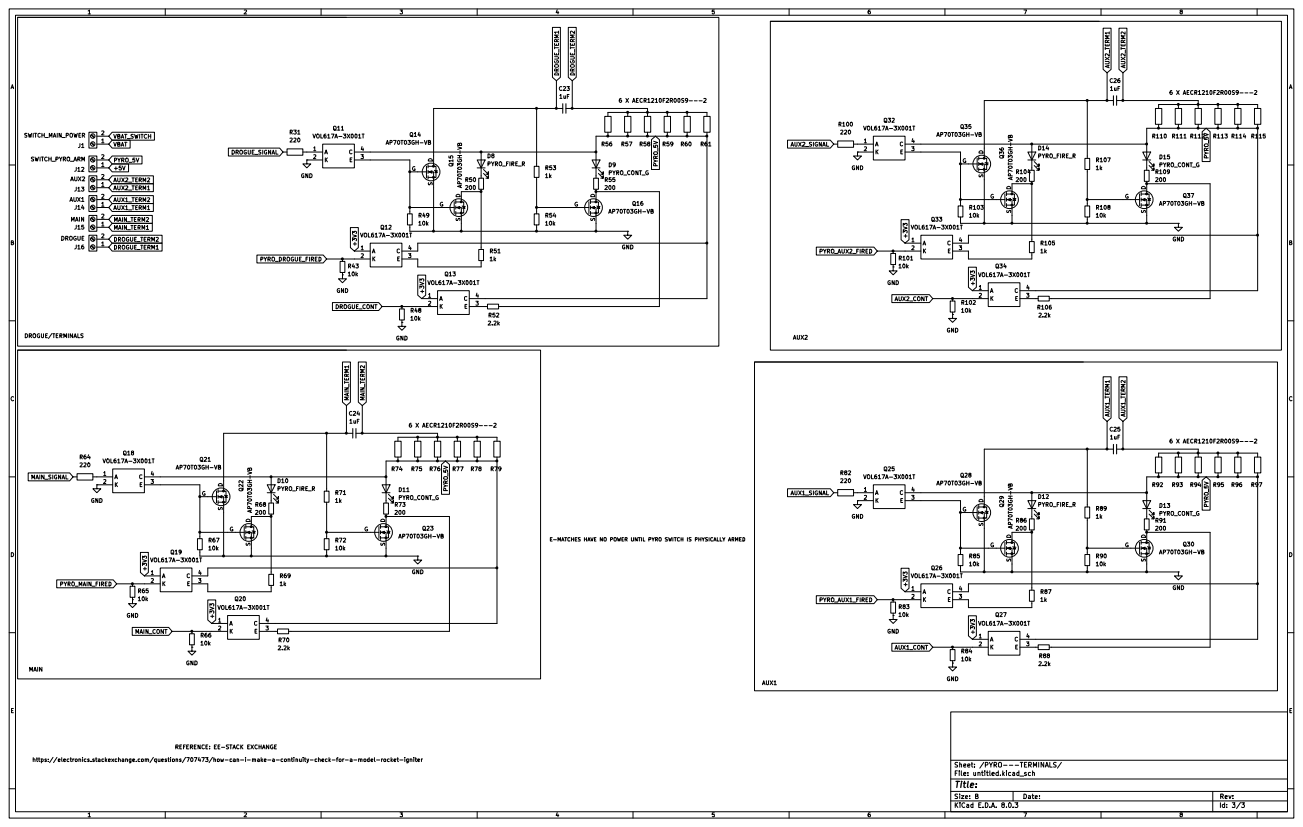
[picture p38: page 3]
