tmn24/HAVOC/(list of files, drawings)

Other design files:
HVT1.0(DO_NOT_USE)/SYMBOLS&FOOTPRINTS/LIB_STM32H755IIT6/STM32H755IIT6/Altium/QFP50P2600X2600X160-176N.PcbLib
HVT1.0(DO_NOT_USE)/SYMBOLS&FOOTPRINTS/LIB_STM32H755IIT6/STM32H755IIT6/Altium/STM32H755IIT6.SchLib
HVT1.0(DO_NOT_USE)/SYMBOLS&FOOTPRINTS/LIB_VOL617A-3X001T/VOL617A-3X001T/Altium/SOP254P1015X230-4N.PcbLib
HVT1.0(DO_NOT_USE)/SYMBOLS&FOOTPRINTS/LIB_VOL617A-3X001T/VOL617A-3X001T/Altium/VOL617A-3X001T.SchLib
