tmn24/HAVOC/HVT1.0(DO_NOT_USE)/KICAD8/COMMIT_5/H.A.V.O.C. PCB V 1.0.kicad_sch

## KiCad design HVT1.0(DO_NOT_USE)/KICAD8/COMMIT_5/H.A.V.O.C. PCB V 1.0.kicad_sch (2024-08-28)

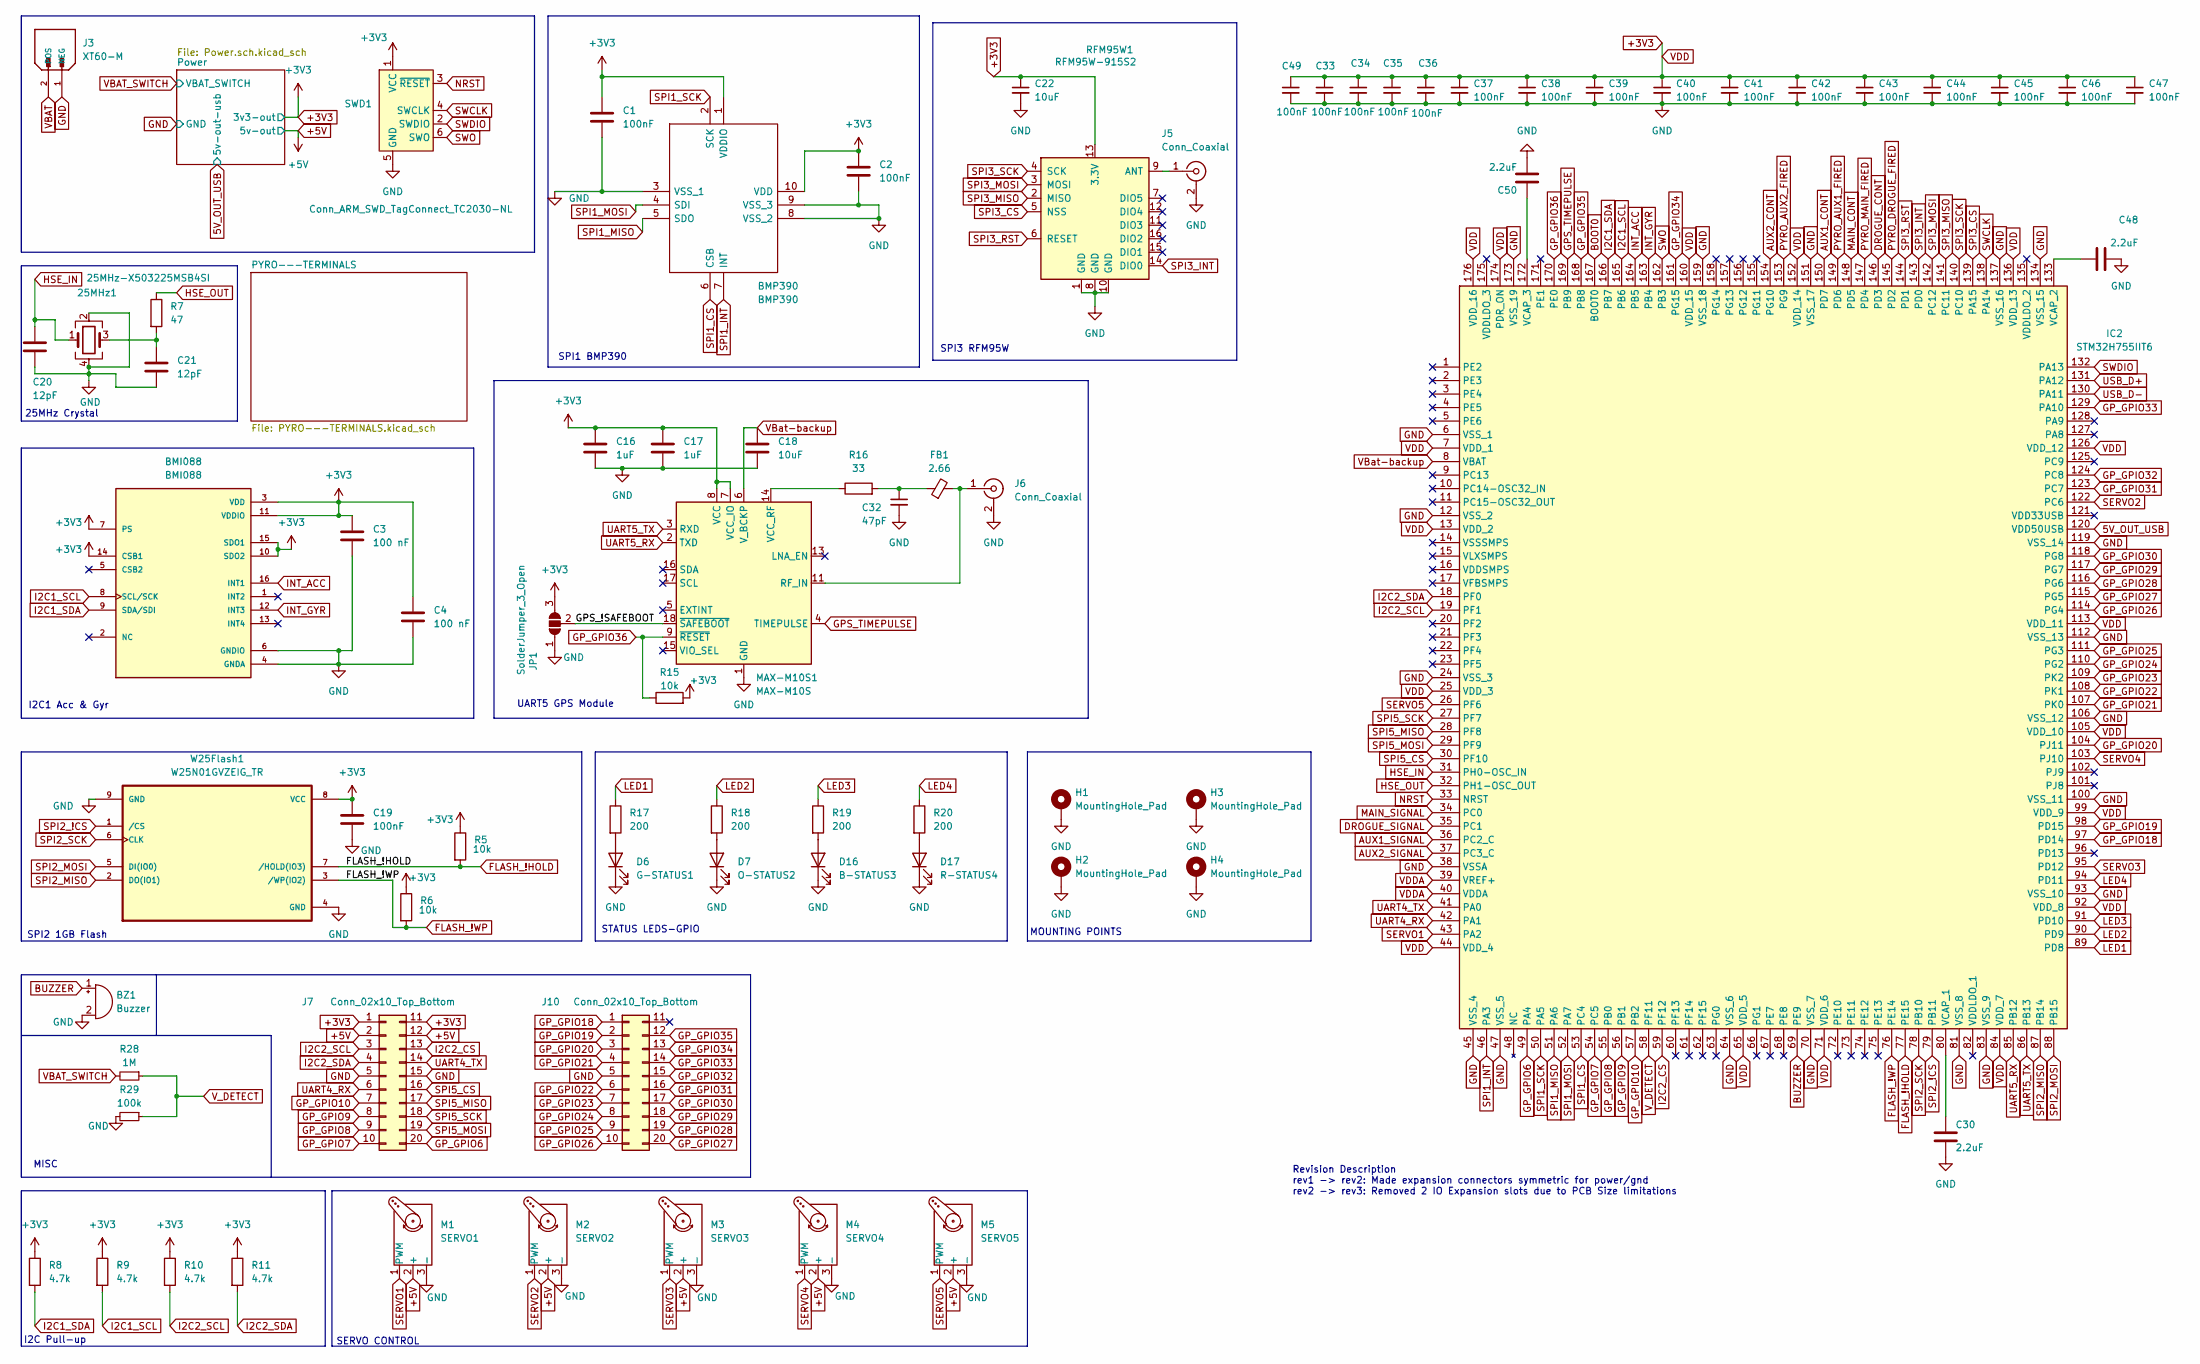
[picture p43: schematic H.A.V.O.C. PCB V 1.0.kicad_sch]

Parts:
25MHz1: 25MHz-X503225MSB4SI; Crystal_SMD_5032-4Pin_5.0x3.2mm
BMI088: BMI088; PQFN50P450X300X100-16N
BMP390: BMP390; 10LGA_2X2X0p75_BOS; Manufacturer_Part_Number BMP390; Mouser Part Number 262-BMP390
BZ1: Buzzer; Buzzer_15x7.5RM7.6
C1, C2: 100nF; C_0603_1608Metric
C3, C4: 100 nF; C_0805_2012Metric
C16, C17: 1uF; C_0603_1608Metric
C18, C22: 10uF; C_0603_1608Metric
C19: 100nF; C_0805_2012Metric
C20, C21: 12pF; C_0805_2012Metric
C30, C48, C50: 2.2uF; C_0805_2012Metric
C32: 47pF; C_0805_2012Metric
C33, C34, C35, C36, C37, C38, C39, C40, C41, C42, C43, C44, C45, C46, C47, C49: 100nF; C_0201_0603Metric
D6: G-STATUS1; LED_0805_2012Metric
D7: O-STATUS2; LED_0805_2012Metric
D16: B-STATUS3; LED_0805_2012Metric
D17: R-STATUS4; LED_0805_2012Metric
FB1: 2.66; L_0402_1005Metric
H1, H2, H3, H4: MountingHole_Pad; MountingHole_3mm_Pad
IC2: STM32H755IIT6; QFP50P2600X2600X160-176N; Manufacturer_Part_Number STM32H755IIT6; Mouser Part Number 511-STM32H755IIT6
J3: XT60-M; AMASS_XT60-M_1x02_P7.20mm_Vertical; PARTREV V1.2
J5, J6: Conn_Coaxial; SMA_Amphenol_901-143_Horizontal
J7, J10: Conn_02x10_Top_Bottom; PinSocket_2x10_P2.54mm_Vertical
JP1: SolderJumper_3_Open; SolderJumper-3_P1.3mm_Open_RoundedPad1.0x1.5mm_NumberLabels
M1: SERVO1; PinHeader_1x03_P2.54mm_Vertical
M2: SERVO2; PinHeader_1x03_P2.54mm_Vertical
M3: SERVO3; PinHeader_1x03_P2.54mm_Vertical
M4: SERVO4; PinHeader_1x03_P2.54mm_Vertical
M5: SERVO5; PinHeader_1x03_P2.54mm_Vertical
MAX-M10S1: MAX-M10S; ublox_MAX
R5, R6, R15: 10k; R_0805_2012Metric
R7: 47; R_0805_2012Metric
R8, R9, R10, R11: 4.7k; R_0805_2012Metric
R16: 33; R_0603_1608Metric
R17, R18, R19, R20: 200; R_0603_1608Metric
R28: 1M; R_0805_2012Metric
R29: 100k; R_0805_2012Metric
RFM95W1: RFM95W-915S2; HOPERF_RFM9XW_SMD
SWD1: Conn_ARM_SWD_TagConnect_TC2030-NL; Tag-Connect_TC2030-IDC-NL_2x03_P1.27mm_Vertical
W25Flash1: W25N01GVZEIG_TR; SON127P800X600X80-9N

Connections:
5V_OUT_USB: IC2.120 (VDD50USB)
+3V3: BMI088.3 (VDD), BMI088.7 (PS), BMI088.10 (SDO2), BMI088.11 (VDDIO), BMI088.14 (CSB1), BMI088.15 (SDO1), BMP390.1 (VDDIO), BMP390.10 (VDD), C1.2, C2.1, C3.1, C4.1, C16.1, C17.1, C19.1, C22.1, C33.1, C34.1, C35.1, C36.1, C37.1, C38.1, C39.1, C40.1, C41.1, C42.1, C43.1, C44.1, C45.1, C46.1, C47.1, C49.1, IC2.7 (VDD_1), IC2.13 (VDD_2), IC2.25 (VDD_3), IC2.44 (VDD_4), IC2.65 (VDD_5), IC2.71 (VDD_6), IC2.84 (VDD_7), IC2.92 (VDD_8), IC2.99 (VDD_9), IC2.105 (VDD_10), IC2.113 (VDD_11), IC2.126 (VDD_12), IC2.136 (VDD_13), IC2.152 (VDD_14), IC2.160 (VDD_15), IC2.174 (PDR_ON), IC2.176 (VDD_16), J7.1, J7.11, JP1.3 (B), MAX-M10S1.7 (VCC_IO), MAX-M10S1.8 (VCC), R5.1, R6.1, R8.1, R9.1, R10.1, R11.1, R15.2, RFM95W1.13 (3.3V), SWD1.1 (VCC), W25Flash1.8 (VCC)
+5V: J7.2, J7.12, M1.2 (+), M2.2 (+), M3.2 (+), M4.2 (+), M5.2 (+)
AUX1_CONT: IC2.150 (PD7)
AUX1_SIGNAL: IC2.36 (PC2_C)
AUX2_CONT: IC2.154 (PG10)
AUX2_SIGNAL: IC2.37 (PC3_C)
BOOT0: IC2.167 (BOOT0)
BUZZER: BZ1.1 (+), IC2.69 (PE9)
DROGUE_CONT: IC2.146 (PD3)
DROGUE_SIGNAL: IC2.35 (PC1)
FLASH_!HOLD: IC2.77 (PE15), R5.2, W25Flash1.7 (/HOLD(IO3))
FLASH_!WP: IC2.76 (PE14), R6.2, W25Flash1.3 (/WP(IO2))
GND: 25MHz1.2, 25MHz1.4, BMI088.4 (GNDA), BMI088.6 (GNDIO), BMP390.3 (VSS_1), BMP390.8 (VSS_2), BMP390.9 (VSS_3), BZ1.2 (-), C1.1, C2.2, C3.2, C4.2, C16.2, C17.2, C18.2, C19.2, C20.2, C21.2, C22.2, C30.2, C32.2, C33.2, C34.2, C35.2, C36.2, C37.2, C38.2, C39.2, C40.2, C41.2, C42.2, C43.2, C44.2, C45.2, C46.2, C47.2, C48.2, C49.2, C50.2, D6.1 (K), D7.1 (K), D16.1 (K), D17.1 (K), H1.1, H2.1, H3.1, H4.1, IC2.6 (VSS_1), IC2.12 (VSS_2), IC2.24 (VSS_3), IC2.38 (VSSA), IC2.45 (VSS_4), IC2.47 (VSS_5), IC2.64 (VSS_6), IC2.70 (VSS_7), IC2.81 (VSS_8), IC2.83 (VSS_9), IC2.93 (VSS_10), IC2.100 (VSS_11), IC2.106 (VSS_12), IC2.112 (VSS_13), IC2.119 (VSS_14), IC2.134 (VSS_15), IC2.137 (VSS_16), IC2.151 (VSS_17), IC2.159 (VSS_18), IC2.173 (VSS_19), J3.1 (NEG), J5.2 (Ext), J6.2 (Ext), J7.5, J7.15, J10.5, JP1.1 (A), M1.3 (-), M2.3 (-), M3.3 (-), M4.3 (-), M5.3 (-), MAX-M10S1.1 (GND), MAX-M10S1.10 (GND), MAX-M10S1.12 (GND), R29.2, RFM95W1.1 (GND), RFM95W1.8 (GND), RFM95W1.10 (GND), SWD1.5 (GND), W25Flash1.4 (GND), W25Flash1.9 (GND)
GPS_!SAFEBOOT: JP1.2 (C), MAX-M10S1.18 (~SAFEBOOT)
GPS_TIMEPULSE: IC2.169 (PB9), MAX-M10S1.4 (TIMEPULSE)
GP_GPIO6: IC2.49 (PA4), J7.20
GP_GPIO7: IC2.54 (PC5), J7.10
GP_GPIO8: IC2.55 (PB0), J7.9
GP_GPIO9: IC2.56 (PB1), J7.8
GP_GPIO10: IC2.57 (PB2), J7.7
GP_GPIO18: IC2.97 (PD14), J10.1
GP_GPIO19: IC2.98 (PD15), J10.2
GP_GPIO20: IC2.104 (PJ11), J10.3
GP_GPIO21: IC2.107 (PK0), J10.4
GP_GPIO22: IC2.108 (PK1), J10.6
GP_GPIO23: IC2.109 (PK2), J10.7
GP_GPIO24: IC2.110 (PG2), J10.8
GP_GPIO25: IC2.111 (PG3), J10.9
GP_GPIO26: IC2.114 (PG4), J10.10
GP_GPIO27: IC2.115 (PG5), J10.20
GP_GPIO28: IC2.116 (PG6), J10.19
GP_GPIO29: IC2.117 (PG7), J10.18
GP_GPIO30: IC2.118 (PG8), J10.17
GP_GPIO31: IC2.123 (PC7), J10.16
GP_GPIO32: IC2.124 (PC8), J10.15
GP_GPIO33: IC2.129 (PA10), J10.14
GP_GPIO34: IC2.161 (PG15), J10.13
GP_GPIO35: IC2.168 (PB8), J10.12
GP_GPIO36: IC2.170 (PE0), MAX-M10S1.9 (~RESET), R15.1
HSE_IN: 25MHz1.1, C20.1, IC2.31 (PH0-OSC_IN)
HSE_OUT: IC2.32 (PH1-OSC_OUT), R7.1
I2C1_SCL: BMI088.8 (SCL/SCK), IC2.165 (PB6), R9.2
I2C1_SDA: BMI088.9 (SDA/SDI), IC2.166 (PB7), R8.2
I2C2_CS: IC2.59 (PF12), J7.13
I2C2_SCL: IC2.19 (PF1), J7.3, R10.2
I2C2_SDA: IC2.18 (PF0), J7.4, R11.2
INT_ACC: BMI088.16 (INT1), IC2.164 (PB5)
INT_GYR: BMI088.12 (INT3), IC2.163 (PB4)
LED1: IC2.89 (PD8), R17.1
LED2: IC2.90 (PD9), R18.1
LED3: IC2.91 (PD10), R19.1
LED4: IC2.94 (PD11), R20.1
MAIN_CONT: IC2.148 (PD5)
MAIN_SIGNAL: IC2.34 (PC0)
NRST: IC2.33 (NRST), SWD1.3 (~RESET)
unnamed: 25MHz1.3, C21.1, R7.2
unnamed: C30.1, IC2.80 (VCAP_1)
unnamed: C32.1, FB1.1, R16.2
unnamed: C48.1, IC2.133 (VCAP_2)
unnamed: C50.1, IC2.172 (VCAP_3)
unnamed: D6.2 (A), R17.2
unnamed: D7.2 (A), R18.2
unnamed: D16.2 (A), R19.2
unnamed: D17.2 (A), R20.2
unnamed: FB1.2, J6.1 (In), MAX-M10S1.11 (RF_IN)
unnamed: J5.1 (In), RFM95W1.9 (ANT)
unnamed: MAX-M10S1.14 (VCC_RF), R16.1
PYRO_AUX1_FIRED: IC2.149 (PD6)
PYRO_AUX2_FIRED: IC2.153 (PG9)
PYRO_DROGUE_FIRED: IC2.145 (PD2)
PYRO_MAIN_FIRED: IC2.147 (PD4)
SERVO1: IC2.43 (PA2), M1.1 (PWM)
SERVO2: IC2.122 (PC6), M2.1 (PWM)
SERVO3: IC2.95 (PD12), M3.1 (PWM)
SERVO4: IC2.103 (PJ10), M4.1 (PWM)
SERVO5: IC2.26 (PF6), M5.1 (PWM)
SPI1_CS: BMP390.6 (CSB), IC2.53 (PC4)
SPI1_INT: BMP390.7 (INT), IC2.46 (PA3)
SPI1_MISO: BMP390.5 (SDO), IC2.51 (PA6)
SPI1_MOSI: BMP390.4 (SDI), IC2.52 (PA7)
SPI1_SCK: BMP390.2 (SCK), IC2.50 (PA5)
SPI2_!CS: IC2.79 (PB11), W25Flash1.1 (/CS)
SPI2_MISO: IC2.87 (PB14), W25Flash1.2 (DO(IO1))
SPI2_MOSI: IC2.88 (PB15), W25Flash1.5 (DI(IO0))
SPI2_SCK: IC2.78 (PB10), W25Flash1.6 (CLK)
SPI3_CS: IC2.139 (PA15), RFM95W1.5 (NSS)
SPI3_INT: IC2.143 (PD0), RFM95W1.14 (DIO0)
SPI3_MISO: IC2.141 (PC11), RFM95W1.2 (MISO)
SPI3_MOSI: IC2.142 (PC12), RFM95W1.3 (MOSI)
SPI3_RST: IC2.144 (PD1), RFM95W1.6 (RESET)
SPI3_SCK: IC2.140 (PC10), RFM95W1.4 (SCK)
SPI5_CS: IC2.30 (PF10), J7.16
SPI5_MISO: IC2.28 (PF8), J7.17
SPI5_MOSI: IC2.29 (PF9), J7.19
SPI5_SCK: IC2.27 (PF7), J7.18
SWCLK: IC2.138 (PA14), SWD1.4 (SWCLK)
SWDIO: IC2.132 (PA13), SWD1.2 (SWDIO)
SWO: IC2.162 (PB3), SWD1.6 (SWO)
UART4_RX: IC2.42 (PA1), J7.6
UART4_TX: IC2.41 (PA0), J7.14
UART5_RX: IC2.85 (PB12), MAX-M10S1.2 (TXD)
UART5_TX: IC2.86 (PB13), MAX-M10S1.3 (RXD)
USB_D+: IC2.131 (PA12)
USB_D-: IC2.130 (PA11)
VBAT: J3.2 (POS)
VBAT_SWITCH: R28.2
VBat-backup: C18.1, IC2.8 (VBAT), MAX-M10S1.6 (V_BCKP)
VDDA: IC2.39 (VREF+), IC2.40 (VDDA)
V_DETECT: IC2.58 (PF11), R28.1, R29.1

Notes on the sheet:
SPI1 BMP390
Revision Description rev1 -> rev2: Made expansion connectors symmetric for power/gnd rev2 -> rev3: Removed 2 IO Expansion slots due to PCB Size limitations
I2C1 Acc & Gyr
SPI2 1GB Flash
SERVO CONTROL
SPI3 RFM95W
UART5 GPS Module
I2C Pull-up
25MHz Crystal
MISC
MOUNTING POINTS
STATUS LEDS-GPIO
