tmn24/HAVOC/HVT1.0(DO_NOT_USE)/KICAD8/COMMIT_5/Power.sch.kicad_sch

## KiCad design HVT1.0(DO_NOT_USE)/KICAD8/COMMIT_5/Power.sch.kicad_sch (2024-08-04)

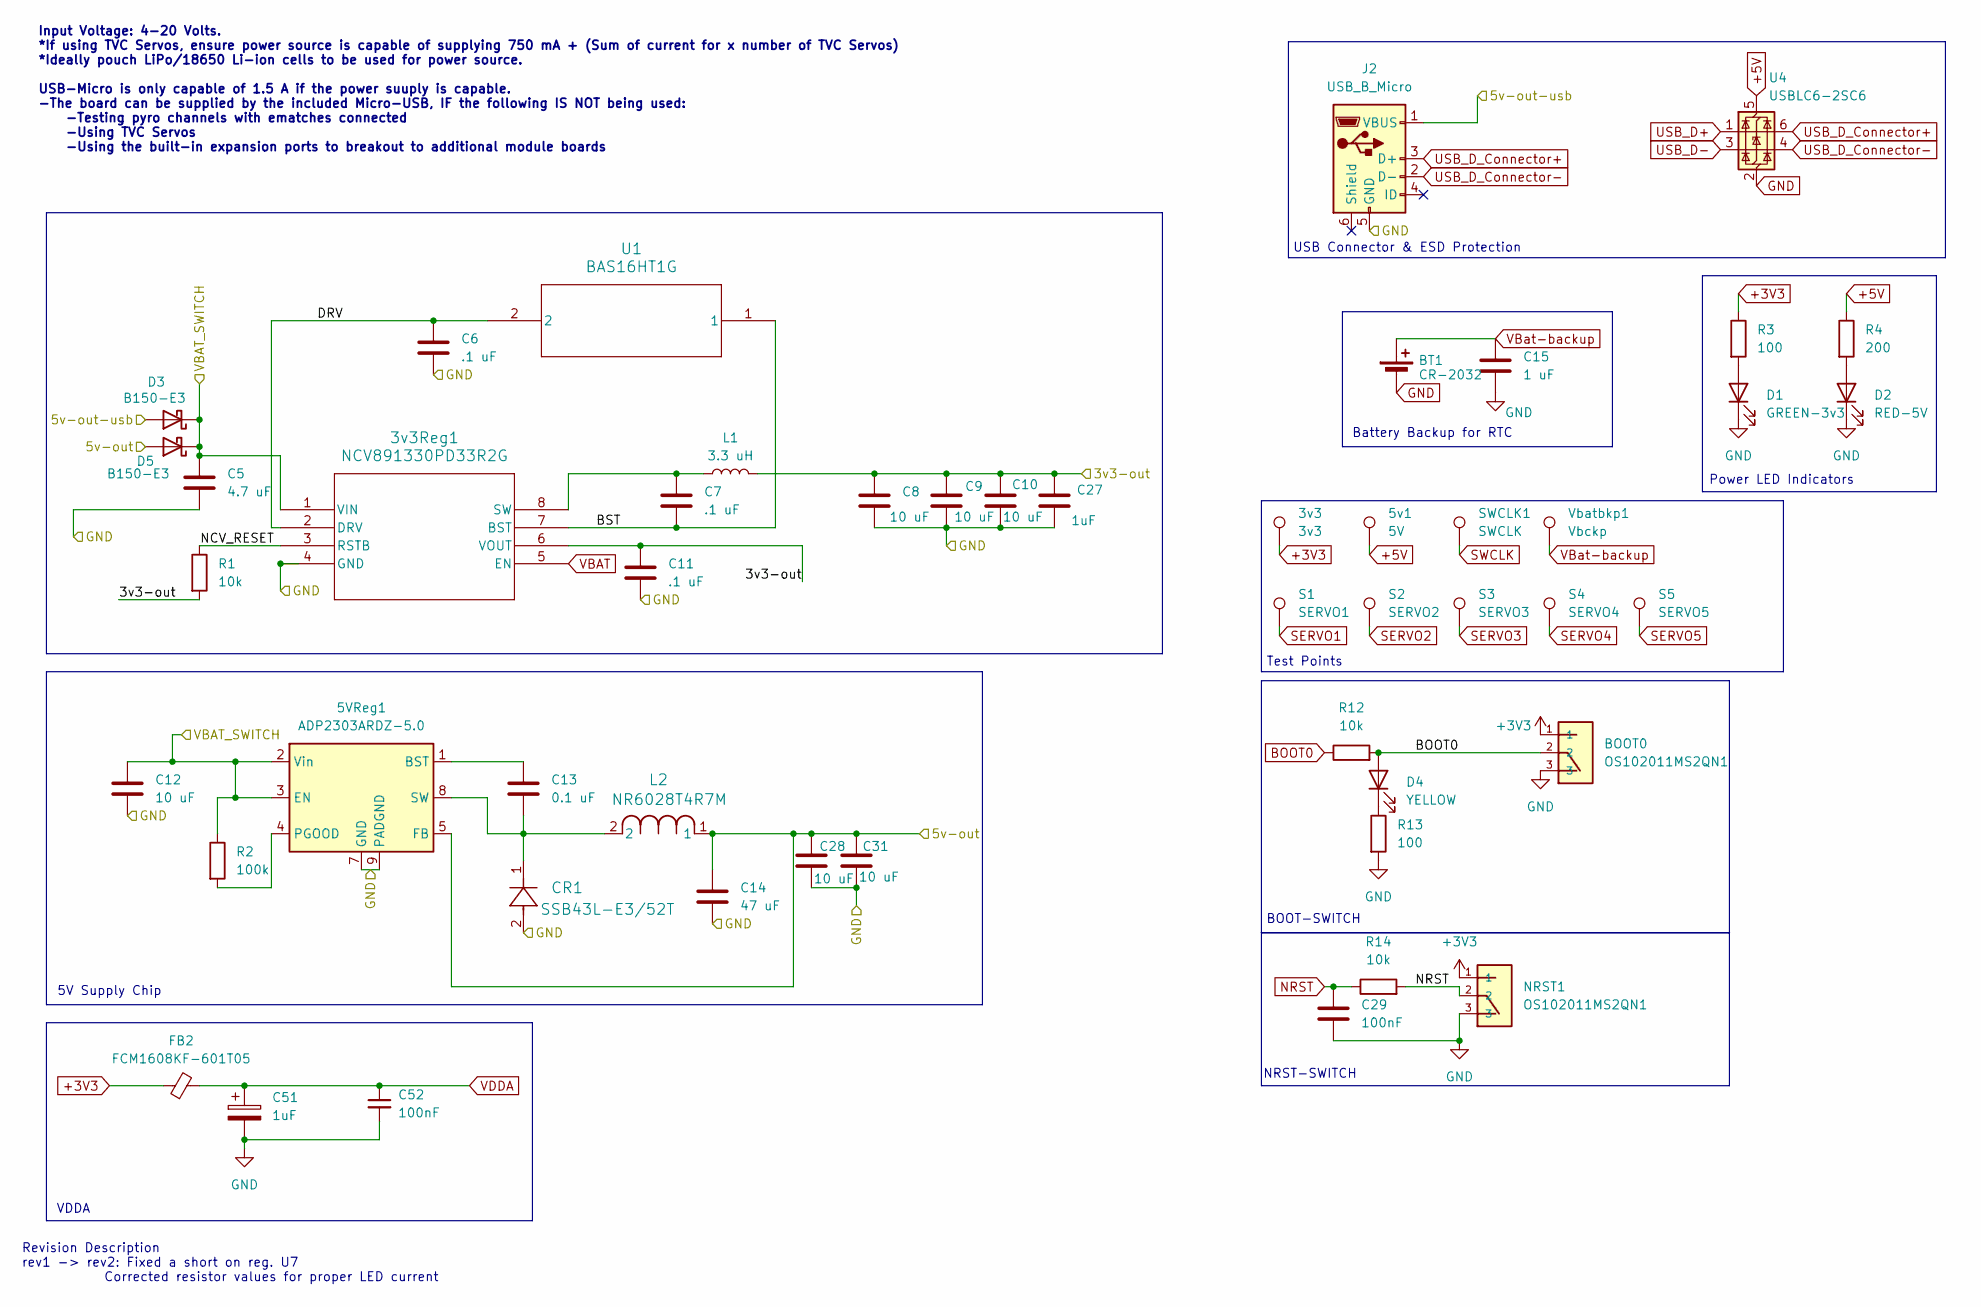
[picture p45: schematic Power.sch.kicad_sch]

Parts:
3v3: 3v3; TestPoint_Pad_1.5x1.5mm
3v3Reg1: NCV891330PD33R2G; SOIC8_3P9X4P9_ONS
5VReg1: ADP2303ARDZ-5.0; SOIC-8-1EP_3.9x4.9mm_P1.27mm_EP2.29x3mm
5v1: 5V; TestPoint_Pad_1.5x1.5mm
BOOT0: OS102011MS2QN1; SW_OS102011MS2QN1; DigiKey_Part_Number CKN9565-ND
BT1: CR-2032; cr 2032 holder
C5: 4.7 uF; C_0805_2012Metric
C6, C7, C11: .1 uF; C_0805_2012Metric
C8, C9, C10, C12, C28, C31: 10 uF; C_0805_2012Metric
C13: 0.1 uF; C_0805_2012Metric
C14: 47 uF; C_0805_2012Metric
C15: 1 uF; C_0603_1608Metric
C27: 1uF; C_0603_1608Metric
C29: 100nF; C_0805_2012Metric
C51: 1uF; CP_Elec_4x5.4
C52: 100nF; C_0201_0603Metric
CR1: SSB43L-E3/52T; DIODE_DO214AA_MBRS
D1: GREEN-3v3; LED_0805_2012Metric
D2: RED-5V; LED_0805_2012Metric
D3, D5: B150-E3; D_SMA
D4: YELLOW; LED_0805_2012Metric
FB2: FCM1608KF-601T05; L_0603_1608Metric
J2: USB_B_Micro; USB_Micro-B_Wuerth_629105150521
L1: 3.3 uH; IND_NRS5030_TAY
L2: NR6028T4R7M; IND_NR6028T4R7M
NRST1: OS102011MS2QN1; SW_OS102011MS2QN1; DigiKey_Part_Number CKN9565-ND
R1: 10k; R_0603_1608Metric
R2: 100k; R_0805_2012Metric
R3: 100; R_0603_1608Metric
R4: 200; R_0603_1608Metric
R12, R14: 10k; R_0805_2012Metric
R13: 100; R_0805_2012Metric
S1: SERVO1; TestPoint_Pad_1.5x1.5mm
S2: SERVO2; TestPoint_Pad_1.5x1.5mm
S3: SERVO3; TestPoint_Pad_1.5x1.5mm
S4: SERVO4; TestPoint_Pad_1.5x1.5mm
S5: SERVO5; TestPoint_Pad_1.5x1.5mm
SWCLK1: SWCLK; TestPoint_Pad_1.5x1.5mm
U1: BAS16HT1G; SOD_16HT1G_ONS
U4: USBLC6-2SC6; SOT-23-6
Vbatbkp1: Vbckp; TestPoint_Pad_1.5x1.5mm

Connections:
3v3-out: 3v3Reg1.6 (VOUT), C8.1, C9.1, C10.1, C11.1, C27.1, L1.2, R1.2
5v-out: 5VReg1.5 (FB), C14.1, C28.1, C31.1, D5.2 (A), L2.1
5v-out-usb: D3.2 (A), J2.1 (VBUS)
+3V3: 3v3.1, BOOT0.1, FB2.1, NRST1.1, R3.1
+5V: 5v1.1, R4.1, U4.5 (VBUS)
BOOT0: BOOT0.2, D4.2 (A), R12.1, R12.2
BST: 3v3Reg1.7 (BST), C7.2, U1.1
DRV: 3v3Reg1.2 (DRV), C6.1, U1.2
GND: 3v3Reg1.4 (GND), 5VReg1.7 (GND), 5VReg1.9 (PADGND), BOOT0.3, BT1.2 (-), C5.2, C6.2, C8.2, C9.2, C10.2, C11.2, C12.2, C14.2, C15.2, C27.2, C28.2, C29.2, C31.2, C51.2, C52.2, CR1.2, D1.1 (K), D2.1 (K), J2.5 (GND), NRST1.3, R13.2, U4.2 (GND)
NCV_RESET: 3v3Reg1.3 (RSTB), R1.1
NRST: C29.1, NRST1.2, R14.1, R14.2
unnamed: 3v3Reg1.8 (SW), C7.1, L1.1
unnamed: 5VReg1.1 (BST), C13.1
unnamed: 5VReg1.4 (PGOOD), R2.2
unnamed: 5VReg1.8 (SW), C13.2, CR1.1, L2.2
unnamed: D1.2 (A), R3.2
unnamed: D2.2 (A), R4.2
unnamed: D4.1 (K), R13.1
SERVO1: S1.1
SERVO2: S2.1
SERVO3: S3.1
SERVO4: S4.1
SERVO5: S5.1
SWCLK: SWCLK1.1
USB_D+: U4.1 (I/O1)
USB_D-: U4.3 (I/O2)
USB_D_Connector+: J2.3 (D+), U4.6 (I/O1)
USB_D_Connector-: J2.2 (D-), U4.4 (I/O2)
VBAT: 3v3Reg1.5 (EN)
VBAT_SWITCH: 3v3Reg1.1 (VIN), 5VReg1.2 (Vin), 5VReg1.3 (EN), C5.1, C12.1, D3.1 (K), D5.1 (K), R2.1
VBat-backup: BT1.1 (+), C15.1, Vbatbkp1.1
VDDA: C51.1, C52.1, FB2.2

Notes on the sheet:
Test Points
USB Connector & ESD Protection
5V Supply Chip
NRST-SWITCH
BOOT-SWITCH
Input Voltage: 4-20 Volts. *If using TVC Servos, ensure power source is capable of supplying 750 mA + (Sum of current for x number of TVC Servos) *Ideally pouch LiPo/18650 Li-ion cells to be used for power source. USB-Micro is only capable of 1.5 A if the power suuply is capable. -The board can be 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
Revision Description rev1 -> rev2: Fixed a short on reg. U7 Corrected resistor values for proper LED current
VDDA
Power LED Indicators
Battery Backup for RTC
