tmn24/HAVOC/HVT1.0(DO_NOT_USE)/KICAD8/COMMIT_5/untitled.kicad_sch

## KiCad design HVT1.0(DO_NOT_USE)/KICAD8/COMMIT_5/untitled.kicad_sch (2024-07-10)

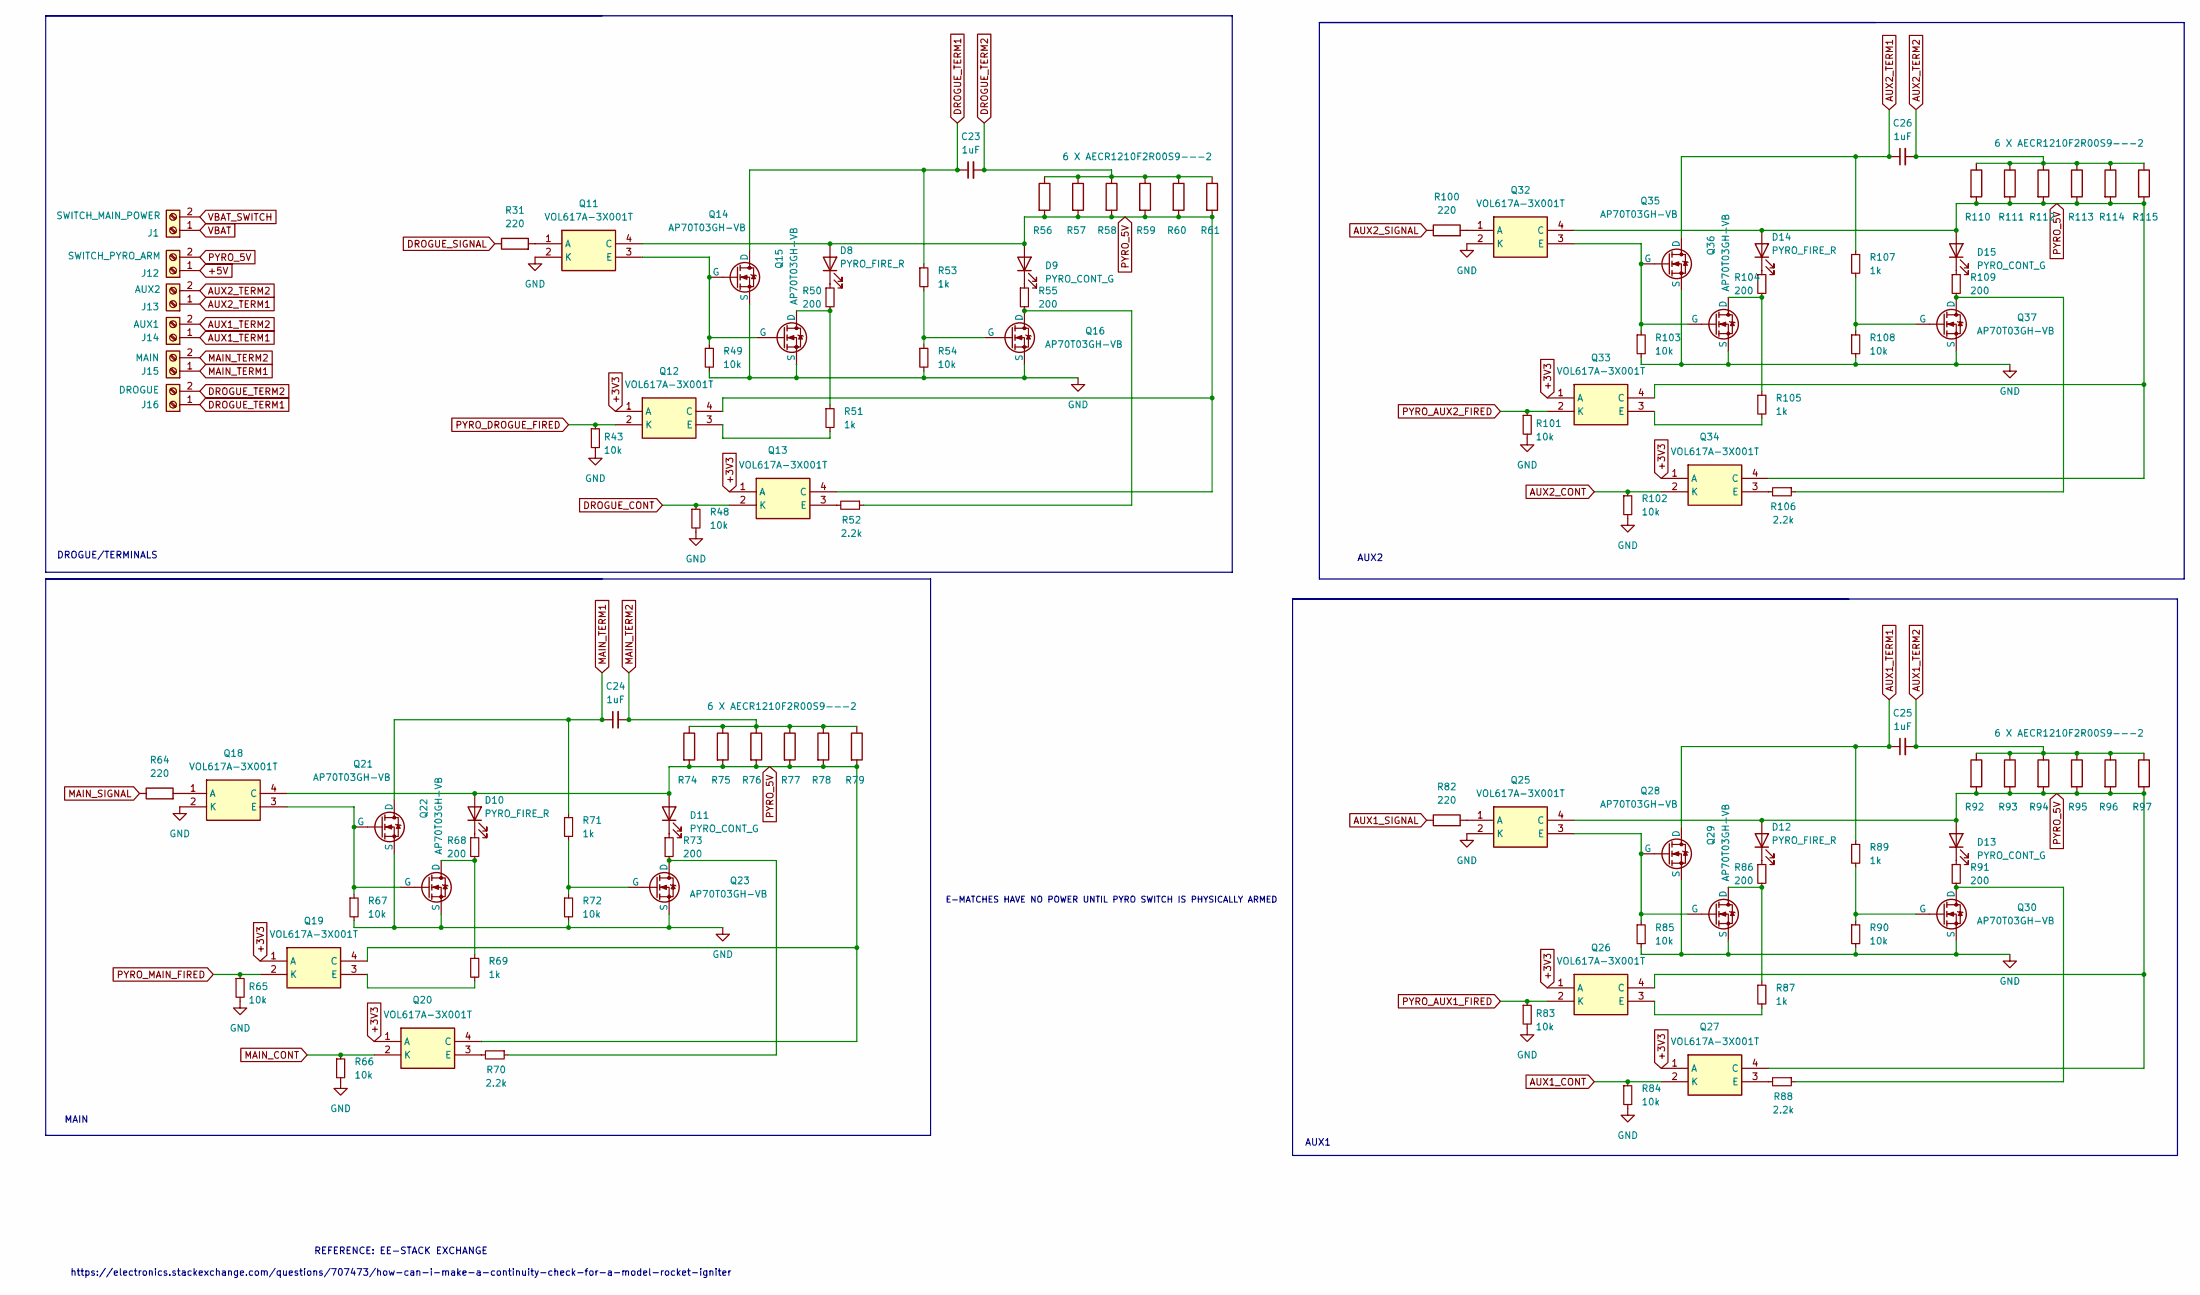
[picture p46: schematic untitled.kicad_sch]

Parts:
C23, C24, C25, C26: 1uF; C_0201_0603Metric
D8, D10, D12, D14: PYRO_FIRE_R; LED_0603_1608Metric
D9, D11, D13, D15: PYRO_CONT_G; LED_0603_1608Metric
J1: SWITCH_MAIN_POWER; TerminalBlock_Wuerth_691311400102_P7.62mm
J12: SWITCH_PYRO_ARM; TerminalBlock_Wuerth_691311400102_P7.62mm
J13: AUX2; TerminalBlock_Wuerth_691311400102_P7.62mm
J14: AUX1; TerminalBlock_Wuerth_691311400102_P7.62mm
J15: MAIN; TerminalBlock_Wuerth_691311400102_P7.62mm
J16: DROGUE; TerminalBlock_Wuerth_691311400102_P7.62mm
Q11, Q12, Q13, Q18, Q19, Q20, Q25, Q26, Q27, Q32, Q33, Q34: VOL617A-3X001T; SOP254P1015X230-4N; Mouser Part Number 78-VOL617A-3X001T
Q14, Q15, Q16, Q21, Q22, Q23, Q28, Q29, Q30, Q35, Q36, Q37: AP70T03GH-VB; TO-252-TEST-HAVOC
R31, R64, R82, R100: 220; R_0805_2012Metric
R43, R48, R49, R54, R65, R66, R67, R72, R83, R84, R85, R90, R101, R102, R103, R108: 10k; R_0603_1608Metric
R50, R55, R68, R73, R86, R91, R104, R109: 200; R_0603_1608Metric
R51, R53, R69, R71, R87, R89, R105, R107: 1k; R_0603_1608Metric
R52, R70, R88, R106: 2.2k; R_0603_1608Metric
R56, R57, R58, R59, R60, R74, R75, R76, R77, R78, R92, R93, R94, R95, R96, R110, R111, R112, R113, R114: AECR1210F2R00S9---2; R_1210_3225Metric
R61, R79, R97, R115: 6 X AECR1210F2R00S9---2; R_1210_3225Metric

Connections:
+3V3: Q12.1 (A), Q13.1 (A), Q19.1 (A), Q20.1 (A), Q26.1 (A), Q27.1 (A), Q33.1 (A), Q34.1 (A)
+5V: J12.1
AUX1_CONT: Q27.2 (K), R84.1
AUX1_SIGNAL: R82.1
AUX1_TERM1: C25.1, J14.1, Q28.1 (D), R89.1
AUX1_TERM2: C25.2, J14.2, R92.1, R93.1, R94.1, R95.1, R96.1, R97.1
AUX2_CONT: Q34.2 (K), R102.1
AUX2_SIGNAL: R100.1
AUX2_TERM1: C26.1, J13.1, Q35.1 (D), R107.1
AUX2_TERM2: C26.2, J13.2, R110.1, R111.1, R112.1, R113.1, R114.1, R115.1
DROGUE_CONT: Q13.2 (K), R48.1
DROGUE_SIGNAL: R31.1
DROGUE_TERM1: C23.1, J16.1, Q14.1 (D), R53.1
DROGUE_TERM2: C23.2, J16.2, R56.1, R57.1, R58.1, R59.1, R60.1, R61.1
GND: Q11.2 (K), Q14.3 (S), Q15.3 (S), Q16.3 (S), Q18.2 (K), Q21.3 (S), Q22.3 (S), Q23.3 (S), Q25.2 (K), Q28.3 (S), Q29.3 (S), Q30.3 (S), Q32.2 (K), Q35.3 (S), Q36.3 (S), Q37.3 (S), R43.2, R48.2, R49.2, R54.2, R65.2, R66.2, R67.2, R72.2, R83.2, R84.2, R85.2, R90.2, R101.2, R102.2, R103.2, R108.2
MAIN_CONT: Q20.2 (K), R66.1
MAIN_SIGNAL: R64.1
MAIN_TERM1: C24.1, J15.1, Q21.1 (D), R71.1
MAIN_TERM2: C24.2, J15.2, R74.1, R75.1, R76.1, R77.1, R78.1, R79.1
unnamed: D8.1 (K), R50.1
unnamed: D9.1 (K), R55.1
unnamed: D10.1 (K), R68.1
unnamed: D11.1 (K), R73.1
unnamed: D12.1 (K), R86.1
unnamed: D13.1 (K), R91.1
unnamed: D14.1 (K), R104.1
unnamed: D15.1 (K), R109.1
unnamed: Q11.1 (A), R31.2
unnamed: Q11.3 (E), Q14.2 (G), Q15.2 (G), R49.1
unnamed: Q12.3 (E), R51.2
unnamed: Q13.3 (E), R52.2
unnamed: Q15.1 (D), R50.2, R51.1
unnamed: Q16.1 (D), R52.1, R55.2
unnamed: Q16.2 (G), R53.2, R54.1
unnamed: Q18.1 (A), R64.2
unnamed: Q18.3 (E), Q21.2 (G), Q22.2 (G), R67.1
unnamed: Q19.3 (E), R69.2
unnamed: Q20.3 (E), R70.2
unnamed: Q22.1 (D), R68.2, R69.1
unnamed: Q23.1 (D), R70.1, R73.2
unnamed: Q23.2 (G), R71.2, R72.1
unnamed: Q25.1 (A), R82.2
unnamed: Q25.3 (E), Q28.2 (G), Q29.2 (G), R85.1
unnamed: Q26.3 (E), R87.2
unnamed: Q27.3 (E), R88.2
unnamed: Q29.1 (D), R86.2, R87.1
unnamed: Q30.1 (D), R88.1, R91.2
unnamed: Q30.2 (G), R89.2, R90.1
unnamed: Q32.1 (A), R100.2
unnamed: Q32.3 (E), Q35.2 (G), Q36.2 (G), R103.1
unnamed: Q33.3 (E), R105.2
unnamed: Q34.3 (E), R106.2
unnamed: Q36.1 (D), R104.2, R105.1
unnamed: Q37.1 (D), R106.1, R109.2
unnamed: Q37.2 (G), R107.2, R108.1
PYRO_5V: D8.2 (A), D9.2 (A), D10.2 (A), D11.2 (A), D12.2 (A), D13.2 (A), D14.2 (A), D15.2 (A), J12.2, Q11.4 (C), Q12.4 (C), Q13.4 (C), Q18.4 (C), Q19.4 (C), Q20.4 (C), Q25.4 (C), Q26.4 (C), Q27.4 (C), Q32.4 (C), Q33.4 (C), Q34.4 (C), R56.2, R57.2, R58.2, R59.2, R60.2, R61.2, R74.2, R75.2, R76.2, R77.2, R78.2, R79.2, R92.2, R93.2, R94.2, R95.2, R96.2, R97.2, R110.2, R111.2, R112.2, R113.2, R114.2, R115.2
PYRO_AUX1_FIRED: Q26.2 (K), R83.1
PYRO_AUX2_FIRED: Q33.2 (K), R101.1
PYRO_DROGUE_FIRED: Q12.2 (K), R43.1
PYRO_MAIN_FIRED: Q19.2 (K), R65.1
VBAT: J1.1
VBAT_SWITCH: J1.2

Notes on the sheet:
MAIN
REFERENCE: EE-STACK EXCHANGE https://electronics.stackexchange.com/questions/707473/how-can-i-make-a-continuity-check-for-a-model-rocket-igniter
DROGUE/TERMINALS
AUX1
AUX2
E-MATCHES HAVE NO POWER UNTIL PYRO SWITCH IS PHYSICALLY ARMED
