tmn24/HAVOC/(commit log)

2024-07-11 Reorganization of Files
    Organized files
    [H.A.V.O.C. PCB V 1.0.kicad_pcb, H.A.V.O.C. PCB V 1.0.kicad_sch, Power.sch.kicad_sch, untitled.kicad_sch]
2024-07-16 Rev2-Annotations & Schematic
    *Added annotations for certain components/systems based on feedback.
    *Added data sheets for most (if not all) chips used
    *Corrected resistor values around LEDs for proper current flow
    *Fixed a short on regulator U7 caused by moving that section of schematic
    *Created an archival system to retain easy access to older hardware designs
    [H.A.V.O.C. PCB V 1.0.kicad_pcb, H.A.V.O.C. PCB V 1.0.kicad_sch, PYRO---TERMINALS.kicad_sch, Power.sch.kicad_sch, untitled.kicad_sch]
2024-08-04 Physical Hardware Design
    *Created the first iteration of the PCB
    *Created 3D model of V1.0.0
    *Created PDF of individual layer views
    *Revised primary schematic page: Removed 2/4 breakout connectors due to lack of need for current design
    *Removed connections for NC pins
    [691214110002.obj, 691214110002.step, 9011436RFX--3DModel-STEP-269445.STEP, ASPI4030S3R3M--3DModel-STEP-400430.STEP, BMI088.step, EDI2CAP.CFG, H.A.V.O.C. PCB V 1.0.kicad_pcb, H.A.V.O.C. PCB V 1.0.kicad_sch]
2024-08-05 Revision 4-Adjusting traces
    Adjusted traces to provide more spacing, received feedback to go to 8 layer pcb pending review from other sources.
    [H.A.V.O.C. PCB V 1.0-BOM.csv, H.A.V.O.C. PCB V 1.0.kicad_sch, PYRO---TERMINALS.kicad_sch, Power.sch.kicad_sch, untitled.kicad_sch]
2024-08-28 Changes to V1 PCB before ordering
    Stitching vias for gnd planes, change to 8 layer board
    [H.A.V.O.C. PCB V 1.0-BOM.csv, H.A.V.O.C. PCB V 1.0.kicad_sch, PYRO---TERMINALS.kicad_sch, Power.sch.kicad_sch, bom.csv, designators.csv, positions.csv, untitled.kicad_sch]
2024-10-21 In-progress Changes
    HVT 1 -> 2, switching to a different format without pyro system. In between development, issues with HVT 1 from manufacturer, one from my design.
    [691214110002.obj, 691214110002.step, 9011436RFX--3DModel-STEP-269445.STEP, ASPI4030S3R3M--3DModel-STEP-400430.STEP, BMI088.step, EDI2CAP.CFG, H.A.V.O.C. PCB V 1.0-BOM.csv, H.A.V.O.C. PCB V 1.0.kicad_pcb]
2024-10-24 Intermediary Progress on HVT2
    Removed pyro circuits for cost reasons, most of layout completed, traces need to be routed still
    [H.A.V.O.C. PCB V 1.0.kicad_pcb, H.A.V.O.C. PCB V 1.0.kicad_sch, Power.sch.kicad_sch]
2024-10-29 HVT2-No Traces
    HVT2 layout complete, no traces yet
    [H.A.V.O.C. PCB V 1.0.kicad_pcb, Power.sch.kicad_sch, freerouting.dsn]
2024-10-31 Changes to gnd planes
    Modified gnd planes- bckp before routing/scripting
    [H.A.V.O.C. PCB V 1.0.kicad_pcb]
2024-11-05 Routed Traces-Preliminary
    Notes:
    -Differential pair is NOT routed yet
    -Need to evaluate for shorts in traces/design rules
    [H.A.V.O.C. PCB V 1.0.kicad_pcb, freerouting.dsn]
2024-11-07 Test commit UART4_TX
    [H.A.V.O.C. PCB V 1.0.kicad_pcb]
